ADivinagracia1/spectre-inverter-capstone/controls-pcb/Ext_CONN.PNG

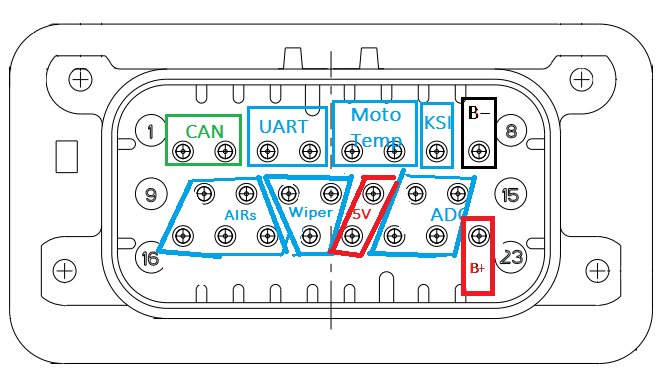
controls-pcb/Ext_CONN.PNG
