ADivinagracia1/spectre-inverter-capstone/controls-pcb/Ext_CONN_v2.PNG

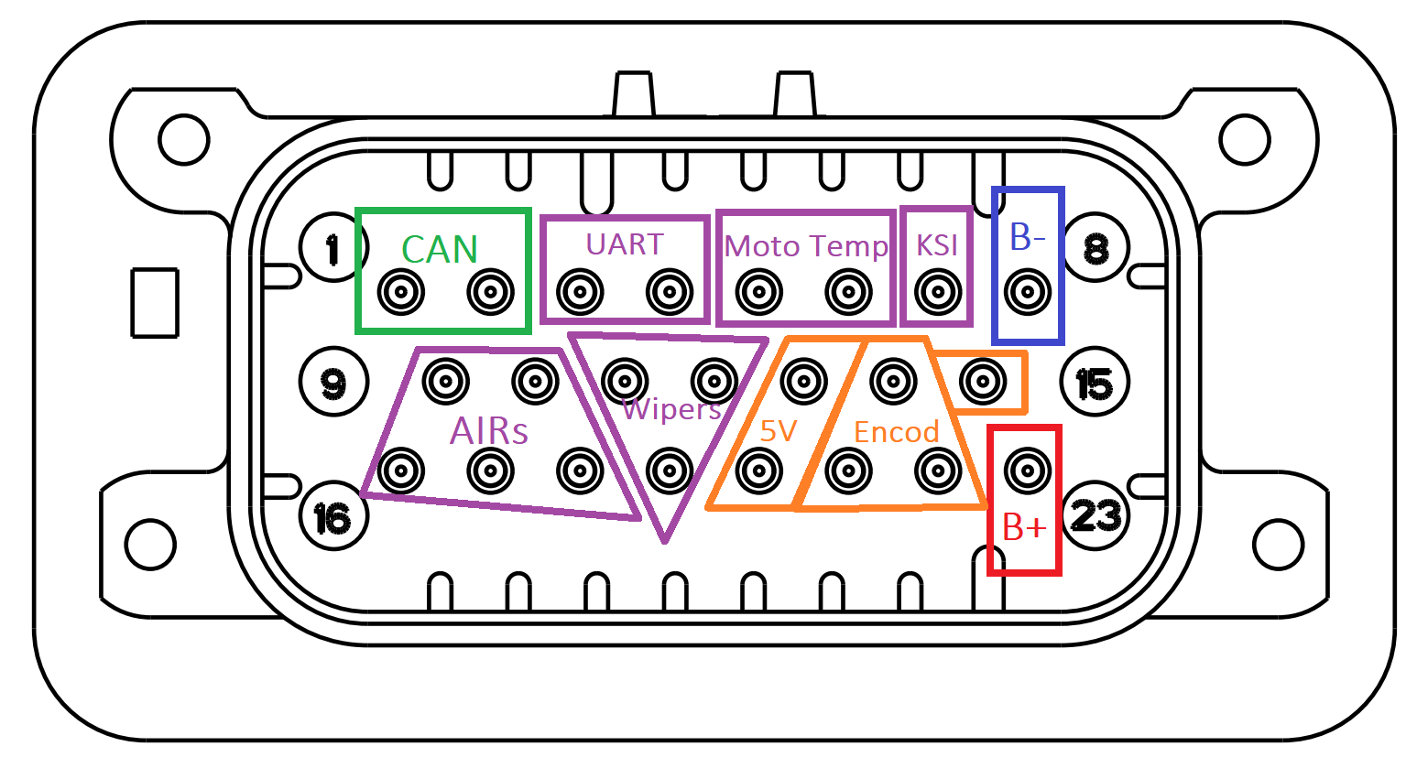
controls-pcb/Ext_CONN_v2.PNG
