ADivinagracia1/spectre-inverter-capstone/controls-pcb/Project Outputs for ControlBoard/ControlBoard.xlsx

Quantity | Designator | Description | Manufacturer | Manufacturer Part Number
6 | C1, C2, C3, C38, C44, C46 | CAP CER 0.1UF 50V Y5V 0805 | KEMET | C0805C104Z5VACTU
2 | C4, C5 | CAP CER 15PF 50V C0G/NPO 0603 | Yageo | CC0603JRNPO9BN150
17 | C6, C7, C8, C9, C10, C11, C12, C13, C14, C15, C21, C24, C32, C36, C49, C52, C53 | CAP CER 0.1UF 50V X7R 0603 | Kyocera AVX, Samsung | 06035C104JAT4A, CL10B104KB8NNNL
4 | C16, C17, C18, C19 | CAP CER 10UF 35V X5R 0603 | Murata | GRM188R6YA106MA73D
1 | C20 | CAP CER 22UF 10V X5R 0603 | Murata | GRM187R61A226ME15D
4 | C22, C23, C33, C34 | CAP CER 2.2UF 50V X5R 0805 | Samsung | CL21A225KBFNNNE
8 | C25, C26, C27, C29, C37, C54, C55, C56 | CAP CER 47UF 10V X5R 1206 | Samsung | CL31A476MPHNNNE
2 | C28, C35 | CAP CER 330PF 100V X7R 0805 | Wurth Electronics | 885012207113
2 | C30, C57 | CAP CER 4700PF 100V X7R 0603 | TDK | CGA3E2X7R2A472K080AA
1 | C31 | CAP CER 10UF 100V X7S 2220 | TDK | C5750X7S2A106K230KB
2 | C39, C40 | CAP CER 1UF 50V X5R 0805 | KEMET | C0805C105K5PACTU
1 | C41 | CAP CER 10UF 25V X7R 1206 | Samsung | CL31B106KAHZW6E
1 | C42 | CAP CER 10000PF 50V X7R 0603 | Kyocera AVX | 06035C103KAT4A
1 | C43 | CAP CER 10UF 16V X5R 0805 | Samsung | CL21A106KOQNNNE
1 | C45 | CAP CER 4.7UF 50V X7R 1206 | TDK | C3216X7R1H475K160AC
2 | C47, C51 | CAP CER 22UF 16V X5R 0805 | Samsung | CL21A226KOQNNNE
1 | C48 | CAP CER SMD 0805 .01UF X7R 5% 50V | KEMET | C0805C103J5RAC7210
1 | C50 | CAP CER 0.047UF 50V X7R 0805 | Yageo | CC0805KRX7R9BB473
8 | D1, D3, D5, D6, D7, D8, D11, D12 | LED GREEN CLEAR 0603 SMD | Wurth Electronics | 150060VS75000
2 | D2, D9 | DIODE SCHOTTKY 60V 5A SMC | Diodes | B560C-13-F
1 | D4 | LED YELLOW CLEAR 0603 SMD | Wurth Electronics | 150060YS75000
1 | D10 | LED RED CLEAR 0603 SMD | Wurth Electronics | 150060RS75000
1 | FB1 | FERRITE BEAD 60 OHM 0805 1LN | Taiyo Yuden | BKP2125HS600-T
1 | FB2 | FERRITE BEAD 220 OHM 0805 1LN | Murata | BLM21PG221SN1D
2 | FB3, FB4 | FERRITE BEAD 23 OHM 1806 1LN | Taiyo Yuden | FBMJ4516HL230NTV
1 | J1 | CONN HEADER VERT 72POS 2.54MM | 3M | 929710-06-36-RK
1 | J2 | CONN HEADER VERT 23POS 4MM | TE Connectivity AMP | 776200-1
1 | J3 | CONN HEADER VERT 16POS 2.54MM | Sullins | PRPC008DAAN-RC
1 | J4 | CONN HEADER VERT 2POS | 3M | 929710-06-01-RK
1 | J5 | CONN HEADER VERT 8POS 2.54MM | Sullins | PREC004DAAN-RC
3 | J6, J7, JP2 | CONN HEADER VERT 2POS 2.54MM | Harwin | M20-9990246
3 | K1, K2, K3 | General Purpose Relay SPST-NO (1 Form A) 12VDC Coil Through Hole | TE Connectivity | OJE-SH-112DM,000
2 | L1, L2 | FIXED IND 3.3UH 5.5A 40.4MOHM SM | Vishay Dale | IHLP2020CZER3R3M11
1 | L3 | FIXED IND 22UH 630MA 700MOHM SMD | Recom | RLS-226
2 | Q1, Q2 | MOSFET N CH 60V 20A TO252 | Diodes | DMN6040SK3-13
9 | R1, R5, R6, R8, R13, R28, R38, R42, R53 | RES SMD 2.2K OHM 5% 1/10W 0603 | Yageo | AC0603JR-072K2L
3 | R2, R4, R41 | RES SMD 62K OHM 1% 1/4W 0603 | Panasonic | ERJ-PA3F6202V
1 | R3 | RES SMD 120 OHM 1% 1/10W 0603 | Yageo | RC0603FR-07120RL
7 | R7, R9, R10, R33, R44, R45, R48 | RES SMD 0 OHM JUMPER 1/10W 0603 | Yageo | RC0603JR-070RL
2 | R11, R14 | RES SMD 10K OHM 5% 1/10W 0603 | Yageo | RC0603JR-0710KL
1 | R12 | THERMISTOR NTC 10KOHM 3380K 0603 | Murata | NCP18XH103F03RB
7 | R15, R16, R19, R22, R23, R25, R27 | RES SMD 1K OHM 1% 1/10W 0603 | Vishay Dale | CRCW06031K00FKEA
1 | R17 | RES SMD 100K OHM 1% 1/10W 0603 | Yageo | RC0603FR-07100KL
2 | R18, R24 | RES SMD 49.9KOHM 0.5% 1/10W 0603 | Vishay Dale | CRCW060349K9DHEAP
1 | R20 | RES SMD 17.8K OHM 1% 1/10W 0603 | Yageo | RC0603FR-0717K8L
1 | R21 | RES SMD 102K OHM 1% 1/10W 0603 | Samsung | RC1608F1023CS
1 | R26 | RES SMD 30K OHM 1% 1/10W 0603 | Yageo | RC0603FR-0730KL
2 | R29, R50 | RES SMD 22.1K OHM 1% 1/10W 0603 | Vishay | CRCW060322K1FKEA
1 | R30 | RES SMD 3K OHM 5% 1/10W 0603 | Yageo | RC0603JR-073KL
3 | R31, R46, R54 | RES SMD 5.1K OHM 1% 1/10W 0603 | TE Connectivity | 1623257-1
1 | R32 | RES 499K OHM 1% 1/10W 0603 | Vishay | CRCW0603499KFKEAC
2 | R34, R35 | RES SMD 270 OHM 0.5% 1/10W 0603 | Yageo | RT0603DRE07270RL
2 | R36, R37 | RES SMD 27 OHM 5% 1/10W 0603 | Panasonic | ERJ-3GEYJ270V
1 | R39 | RES SMD 25 MOHM 1% 2W 2512 | Riedon | CSR2512A0R025F
1 | R40 | RES SMD 10 OHM 1% 1/10W 0603 | Yageo | RC0603FR-0710RL
1 | R43 | RES SMD 200K OHM 1% 1/10W 0603 | Yageo | AF0603FR-07200KL
1 | R47 | RES SMD 7.5K OHM 5% 1/10W 0603 | Yageo | RC0603JR-077K5L
1 | R49 | RES SMD 20K OHM 5% 1/10W 0603 | Yageo | RC0603JR-0720KL
1 | S1 | SWITCH TACTILE SPST-NO 0.05A 12V | ITT C&K | PTS645SM43SMTR92LFS
2 | TVS1, TVS2 | TVS DIODE 5.5V 6SON | Texas Instruments | TPD4E001DRSR
1 | TVS3 | TVS DIODE 18VWM 39.3VC SMA | STMicroelectronics | SMAJ18CA-TR
1 | U1 | IC TRANSCEIVER 1/1 8SOIC | Texas Instruments | TCAN332DR
1 | U2 | IC WDT CIRCUIT SOT323-5 | STMicroelectronics | STWD100PYW83F
1 | U3 | IC MCU 32BIT 256KB FLASH 64LQFP | Texas Instruments | F280049CPMS
2 | U4, U7 | IC REG BUCK ADJUSTABLE 5A 8SOPWR | Texas Instruments | LMR14050SSQDDARQ1
2 | U5, U6 | IC OR CTRLR SRC SELECT 8TSSOP | Texas Instruments | TPS2115APWR
1 | U8 | Module DC-DC 5VIN 1-OUT 5V 0.2A 1W 4-Pin SIP Tube | Recom | ROE-0505S
1 | U10 | IC COMPAR PWR RRI DL PP 8VSSOP | Texas Instruments | TLV3202AIDGK
1 | U11 | IC REG LINEAR 5V 200MA SMV | Toshiba | TAR5S50TE85LF
1 | U12 | IC REG LINEAR 3.3V 1A SOT223 | Diodes | AZ1117IH-3.3TRG1
1 | U13 | IC USB SERIAL FULL UART 20SSOP | FTDI | FT231XS-R
1 | U14 | IC SURGE STOPPER HV 12-MSOP | Analog Devices / Linear Technology | LT4363CMS-2#PBF
1 | X1 | CONN_JTAG_10pin .050 Connector Dual Header 10 Position Surface Mount | Samtec | FTSH-105-01-F-DV-K
1 | X2 | CONN_USB - micro B USB 2.0 Receptacle Connector 5 Position Surface Mount, Right Angle, Horizontal | Amphenol FCI | 10118192-0001LF
1 | Y1 | CRYSTAL 20.0000MHZ 18PF SMD | ECS International | ECS-200-18-30B-AGN-TR
3 | Z1, Z2, Z3 | DIODE ZENER 5.1V 500MW SOD123 | ON Semiconductor | SZMMSZ4689T1G
1 | Z4 | Diode Zener Single 15V 5% 500mW 2-Pin SMA T/R | ON Semiconductor | 1SMA5929BT3G
