ADivinagracia1/spectre-inverter-capstone/power-pcb/Project Outputs for PowerBoard/PowerBoard.xlsx

Comment | Description | Designator | Manufacturer Part Number | Quantity
1uF | CAP CER 1UF 50V X5R 0805 | C1, C2, C4, C6, C9, C10, C12, C14, C17, C18, C20, C22, C25, C26, C28, C30, C33, C34, C36, C38, C42, C43, C45, C47, C59 | C0805C105K5PACTU | 25
4.7uF | CAP CER 4.7UF 50V X7R 1206 | C3, C11, C19, C27, C35, C44 | C3216X7R1H475K160AC | 6
0.1uF | CAP CER 0.1UF 50V Y5V 0805 | C5, C13, C21, C29, C37, C46, C50, C51, C52, C53, C54, C55, C56, C57 | C0805C104Z5VACTU | 14
15uF | CAP CER 15UF 25V X7R 1812 | C7, C8, C15, C16, C23, C24, C31, C32, C40, C41, C48, C49 | C4532X7R1E156M280KB | 12
150uF | CAP POLYMER HYBRID 150UF 50V SMD | C39, C66, C67 | EEHZS1H151P | 3
50UF | CAP FILM 50UF 10% 500VDC RADIAL | C60, C61, C62, C63, C64, C65 | C4AQLBW5500A3JK | 6
37pF | CAP CER 39PF 50V C0G/NP0 0805 | C68, C69, C70 | CL21C390JBANNNC | 3
US1NWF-7 | DIODE GEN PURP 1.2KV 1A SOD123F | D1, D2, D3 | US1NWF-7 | 3
M8 Terminal | M8 Screw terminal for HV connections | J1, J3, J4, J5, J6 |  | 5
1-534998-5 | 30 Position Receptacle Connector 0.100" (2.54mm) Through Hole Gold | J2 | 1-534998-5 | 1
PPPC021LFBN-RC | CONN HDR 2POS 0.1 GOLD PCB | J7 | PPPC021LFBN-RC | 1
STGB30V60DF | IGBT 600V 60A 258W D2PAK | Q1_HA, Q1_LA, Q2_HA, Q2_LA, Q3_HA, Q3_LA, Q4_HA, Q4_LA, Q5_HA, Q5_LA, Q6_HA, Q6_LA, Q7_HA, Q7_LA, Q8_HB, Q8_LB, Q9_HB, Q9_LB, Q10_HB, Q10_LB, Q11_HB, Q11_LB, Q12_HB, Q12_LB, Q13_HB, Q13_LB, Q14_HB, Q14_LB, Q15_HC, Q15_LC, Q16_HC, Q16_LC, Q17_HC, Q17_LC, Q18_HC, Q18_LC, Q19_HC, Q19_LC, Q20_HC, Q20_LC, Q21_HC, Q21_LC | STGB30V60DF | 42
STL12N60M2 | MOSFET N-CH 600V 6.5A POWERFLAT | Q22 | STL12N60M2 | 1
10R | RES SMD 10 OHM 1% 1/10W 0603 | R1, R7_HA, R7_LA, R8_HA, R8_LA, R9_HA, R9_LA, R10_HA, R10_LA, R11_HA, R11_LA, R12_HA, R12_LA, R13_HA, R13_LA, R14, R20_HB, R20_LB, R21_HB, R21_LB, R22_HB, R22_LB, R23_HB, R23_LB, R24_HB, R24_LB, R25_HB, R25_LB, R26_HB, R26_LB, R27, R33_HC, R33_LC, R34_HC, R34_LC, R35_HC, R35_LC, R36_HC, R36_LC, R37_HC, R37_LC, R38_HC, R38_LC, R39_HC, R39_LC, R102, R103, R104, R105, R106, R107 | RC0603FR-0710RL | 51
120R | RES SMD 120 OHM 1% 1/10W 0603 | R2, R3, R5, R6, R15, R16, R18, R19, R28, R29, R31, R32 | RC0603FR-07120RL | 12
200uR | RES SMD 200 UOHM 1% 12W 3920 | R4, R17, R30 | CSS2H-3920R-L200FE | 3
10K | RES SMD 10K OHM 5% 1/10W 0603 | R40, R41, R42, R60 | RC0603JR-0710KL | 4
10K NTC | THERMISTOR NTC 10KOHM 3380K 0603 | R45, R46, R47 | NCP18XH103F03RB | 3
200K | RES SMD 200K OHM 1% 1/10W 0603 | R50 | AF0603FR-07200KL | 1
2K | RES SMD 2K OHM 1% 1/4W 0603 | R51 | CRCW06032K00FKEAHP | 1
10K | RES SMD 10K OHM 1% 3/4W 1206 | R52, R53, R54, R55, R56, R57, R58, R59, R61, R62, R63, R64, R65, R66, R67, R68, R70, R71, R72, R73, R74, R75, R76, R77, R78, R79, R80, R81, R82, R83, R84, R85, R86, R87, R88, R89, R90, R91, R92, R93, R94, R95, R96, R97, R98, R99, R100, R101 | RCA120610K0FKEAHP | 48
MGJ2D121509SC | Isolated Module DC DC Converter Output 15V -8.7V - 80mA, 40mA 10.8V - 13.2V Input | U1, U3, U5, U7, U9, U11 | MGJ2D121509SC | 6
STGAP2HSMTR | GALVANICALLY ISOLATED 4 A SINGLE GATE DRIVER | U2, U4, U6, U8, U10, U12 | ERF8-010-07.0-L-DV-L-K-TR | 6
AMC1200BDUBR | IC OPAMP ISOLATION 1 CIRC 8SOP | U13, U14, U15, U16 | AMC1200BDUBR | 4
BU4SU69G2 | IC INVERTER 1CH 1-INP 5SSOP | U18 | BU4SU69G2-TR | 1
