ADivinagracia1/spectre-inverter-capstone/controls-pcb/ControlBoard.pdf

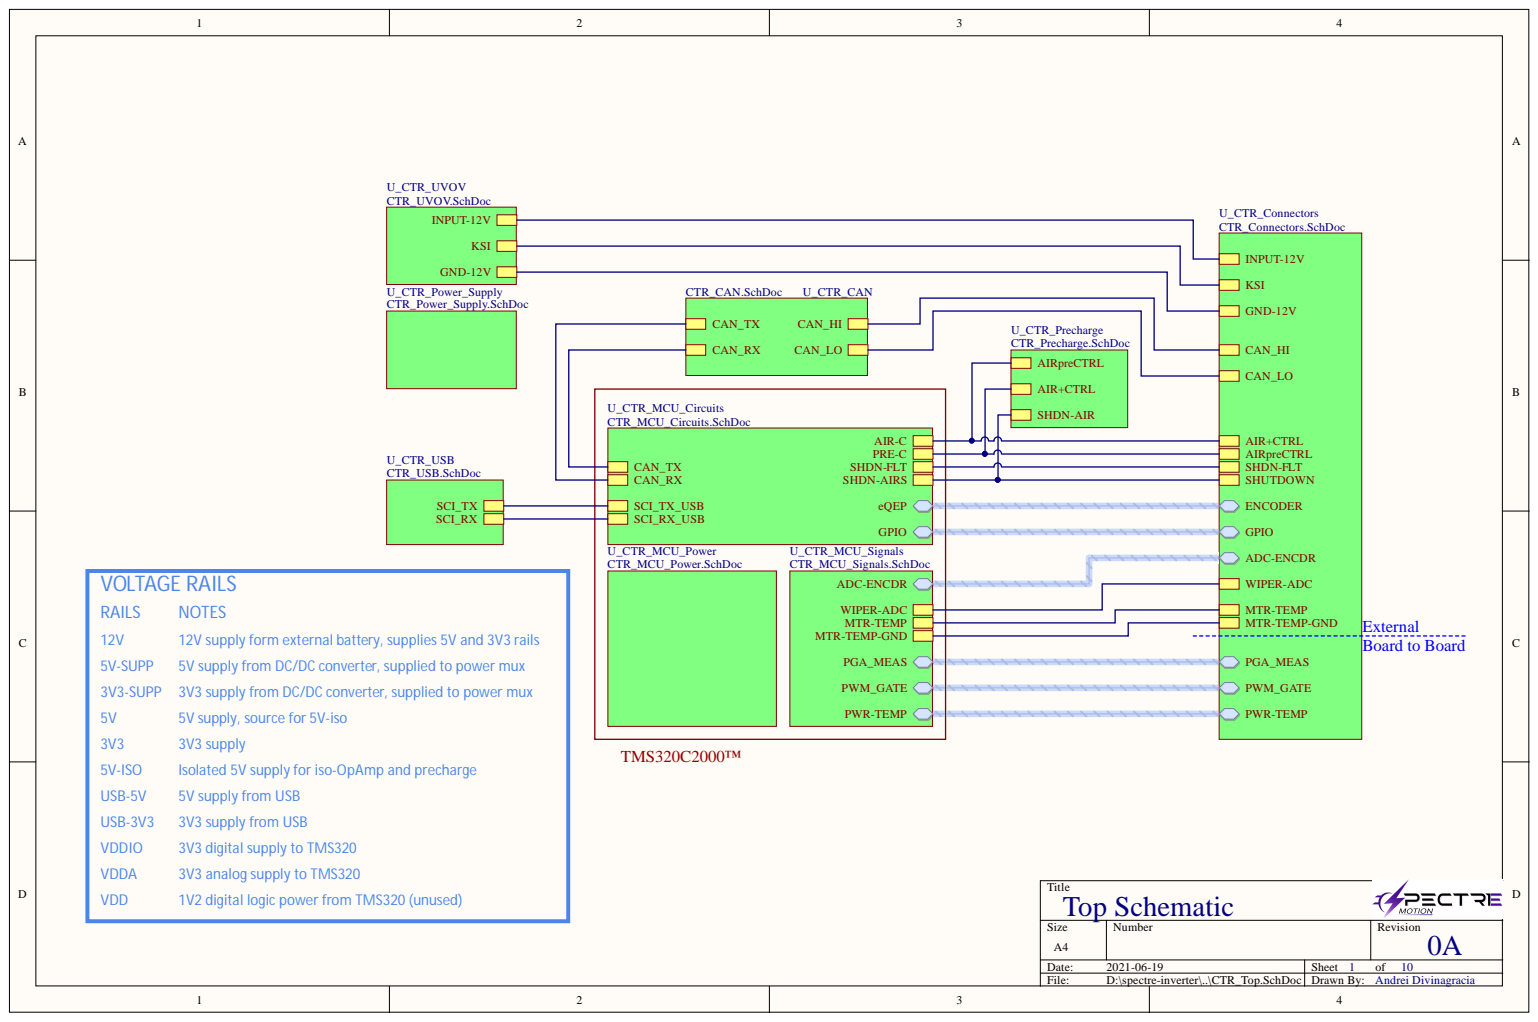
[picture p3: page 1]

12V supply form external battery, supplies 5V and 3V3 rails
5V supply from DC/DC converter, supplied to power mux
3V3 supply from DC/DC converter, supplied to power mux
5V supply, source for 5V-iso
3V3 supply
Isolated 5V supply for iso-OpAmp and precharge
5V supply from USB
3V3 supply from USB
3V3 digital supply to TMS320
3V3 analog supply to TMS320
1V2 digital logic power from TMS320 (unused)

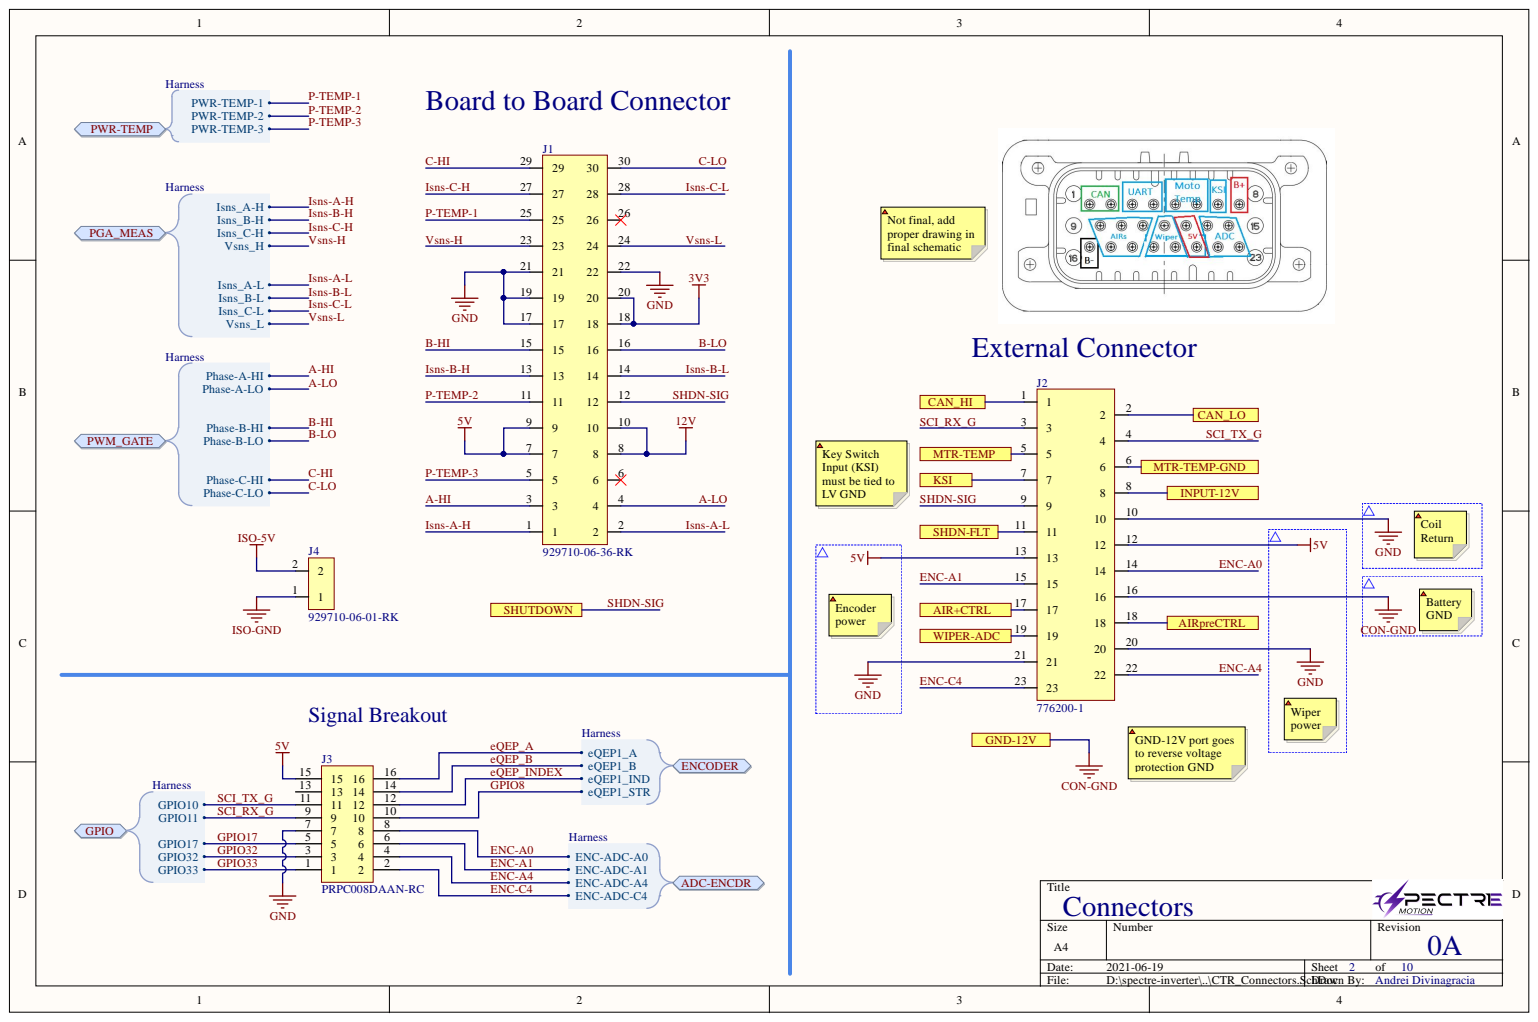
[picture p4: page 2]

Board to Board Connector

Key Switch
Input (KSI)
must be tied to
LV GND

GND

CON-GND

ENC-A0
ENC-A1
ENC-A4

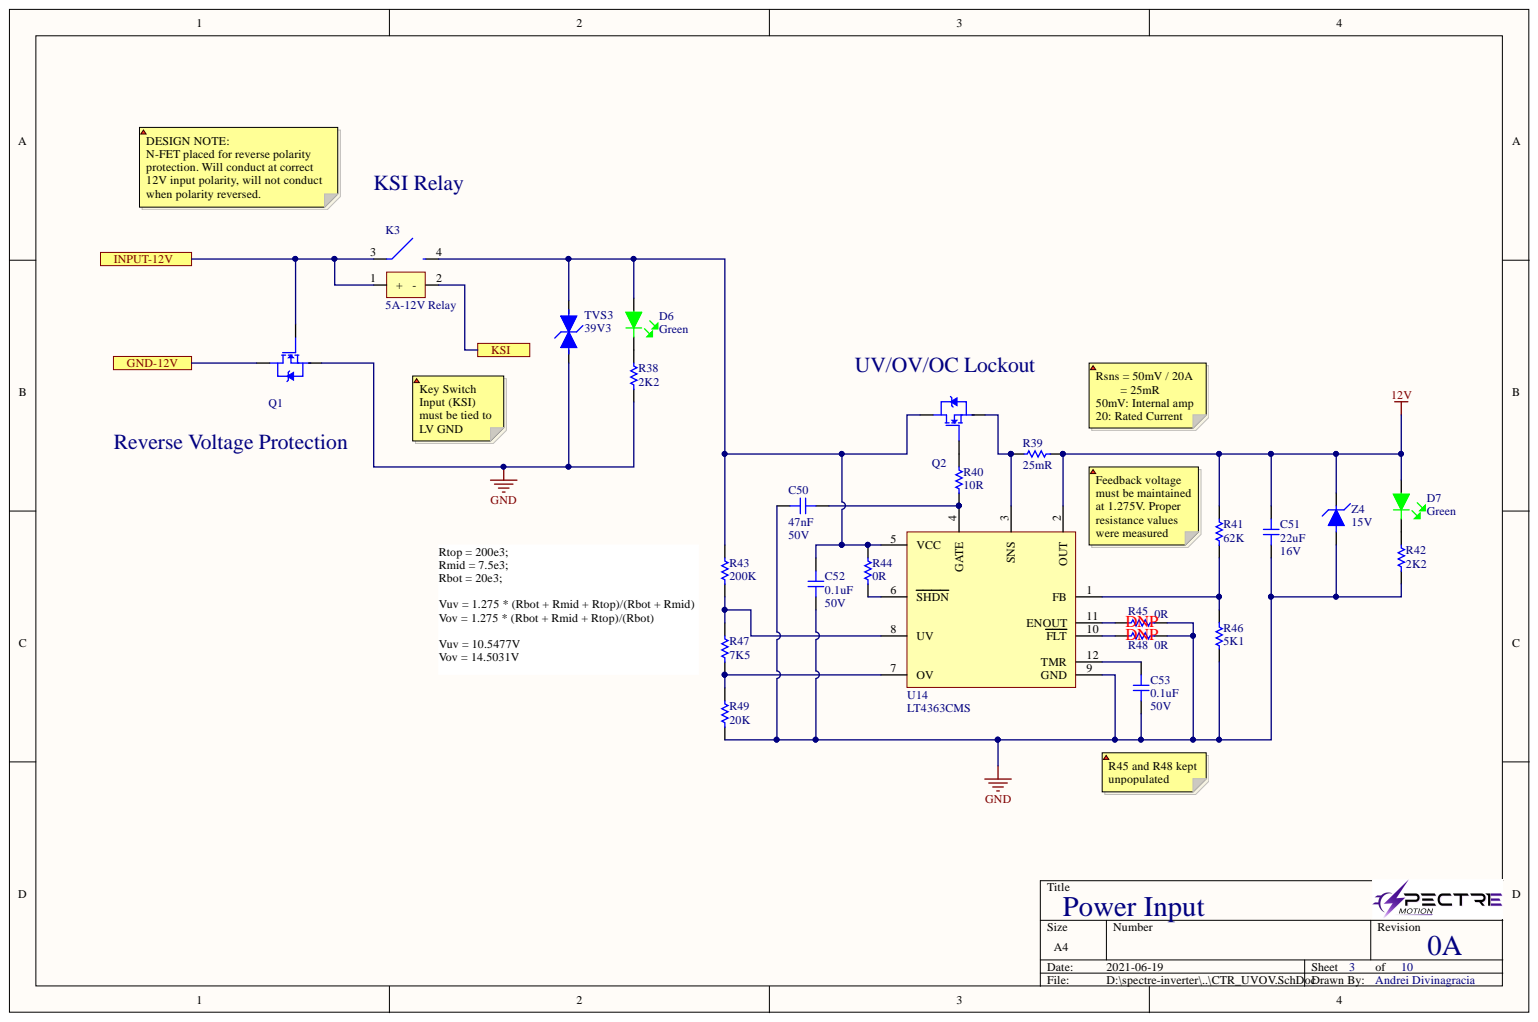
[picture p5: page 3]

UV/OV/OC Lock

Power Input DNP DNP

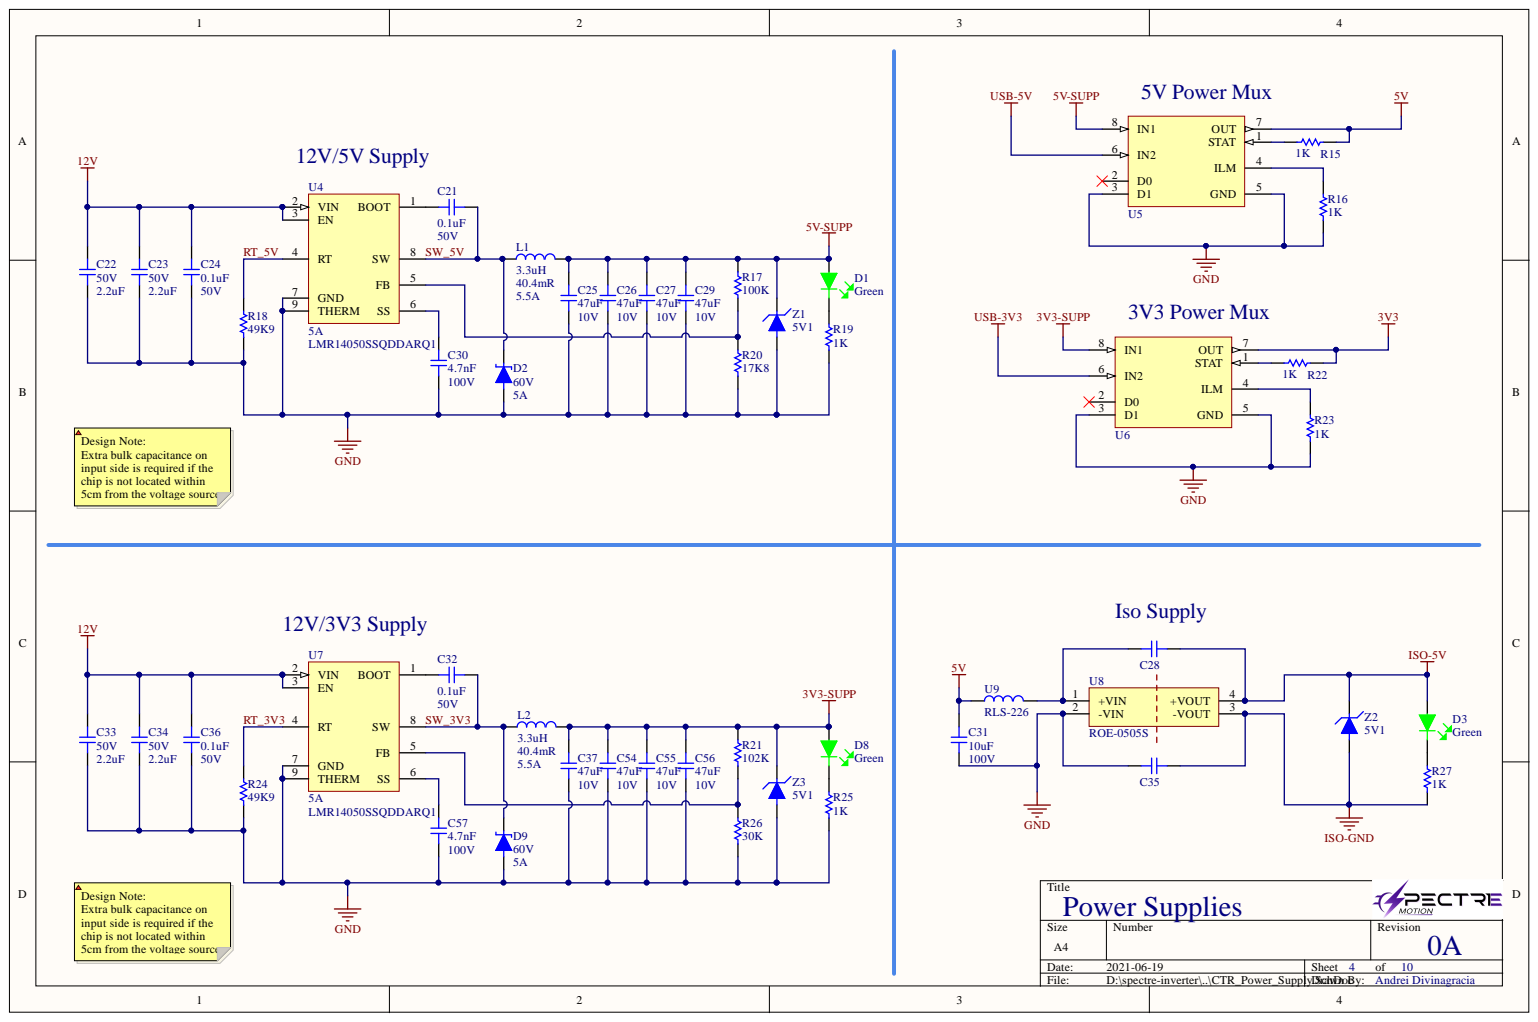
[picture p6: page 4]

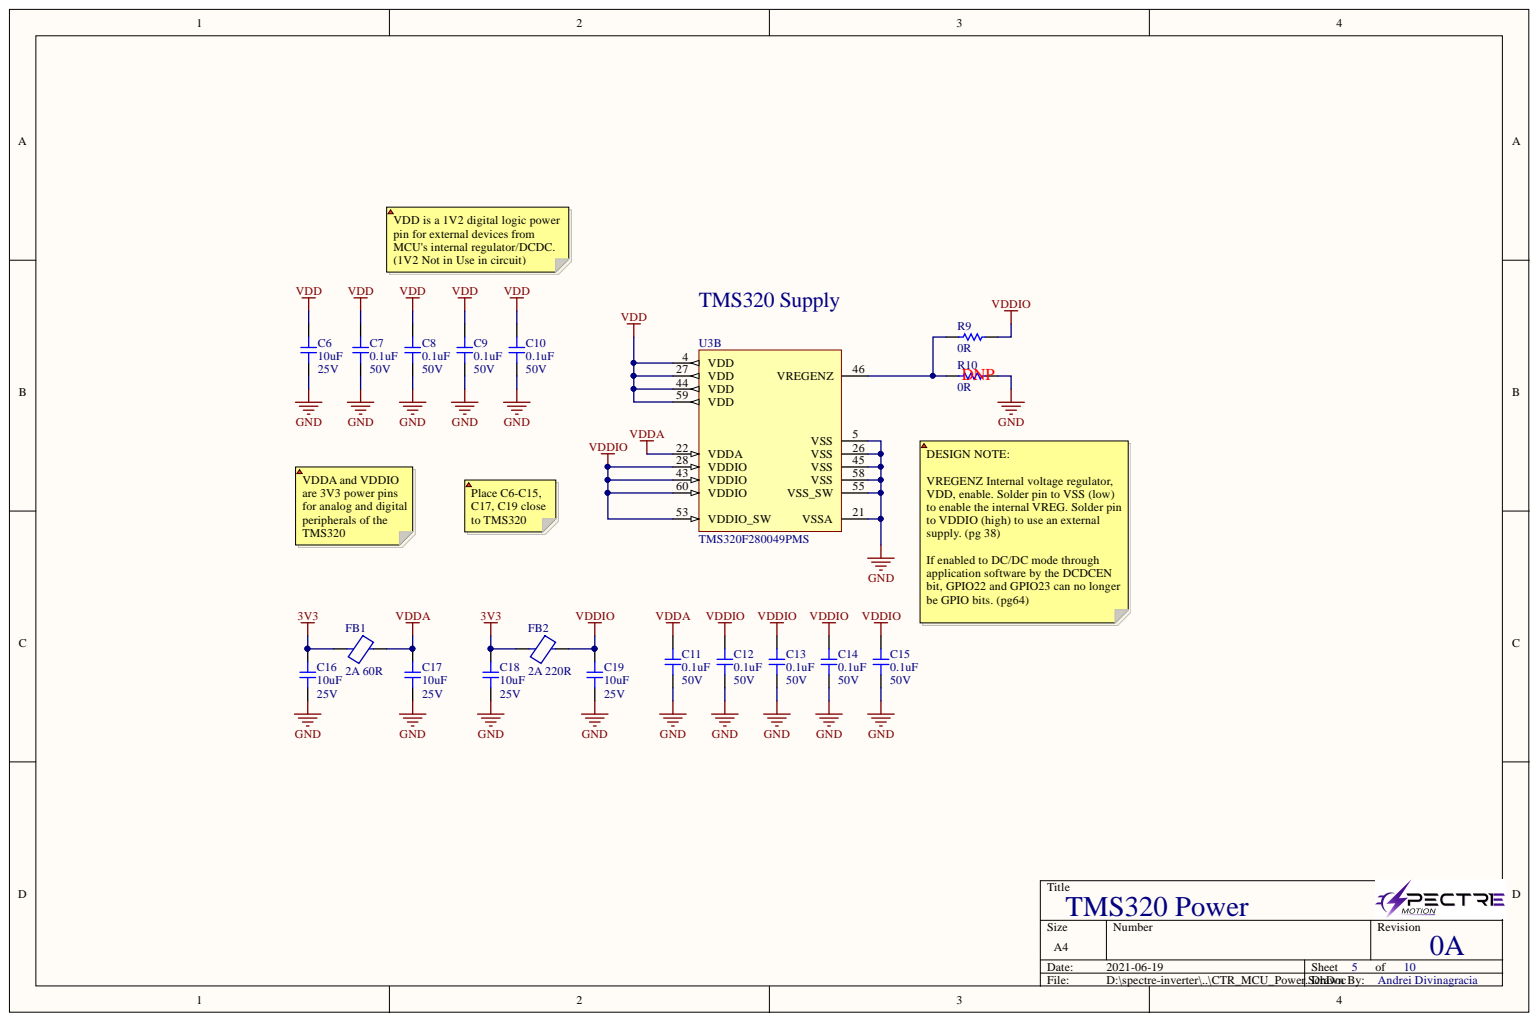
[picture p7: page 5]

VDD is a 1V2 digital logic power
pin for external devices from
MCU's internal regulator/DCDC.
(1V2 Not in Use in circuit)

VDDA and VDDIO
are 3V3 power pins
for analog and digital
peripherals of the
TMS320

VREGENZ Internal voltage regulator,
VDD, enable. Solder pin to VSS (low)
to enable the internal VREG. Solder pin
to VDDIO (high) to use an external
supply. (pg 38)

If enabled to DC/DC mode through
application software by the DCDCEN
bit, GPIO22 and GPIO23 can no longer
be GPIO bits. (pg64)

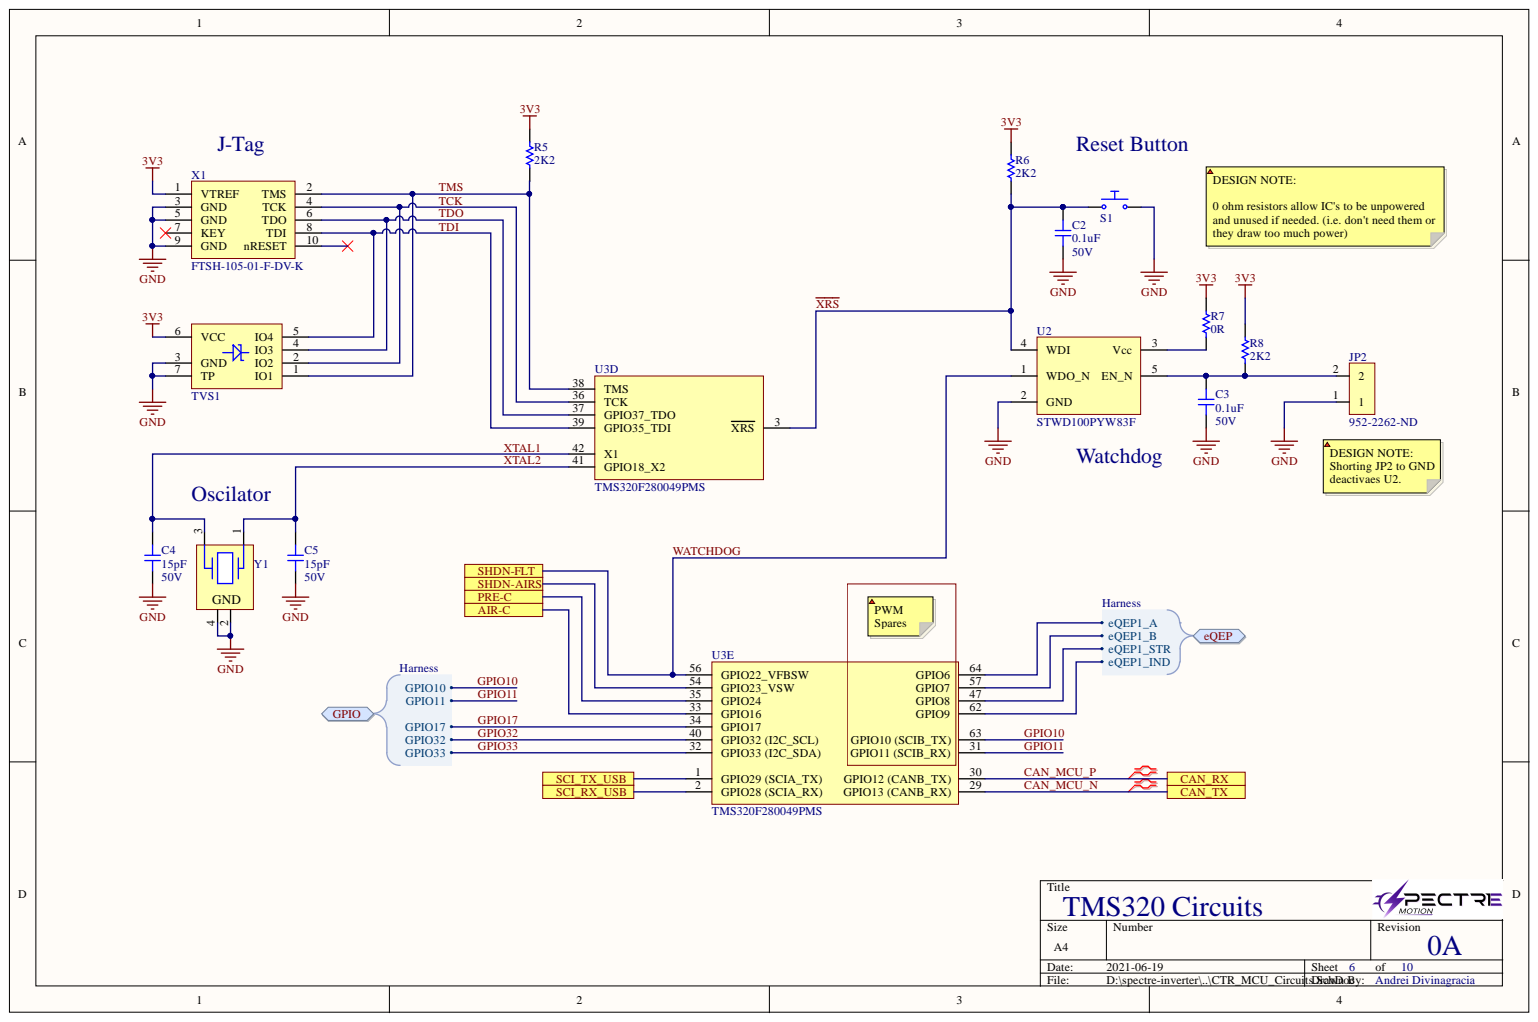
[picture p8: page 6]

0 ohm resistors allow IC's to be unpowered
and unused if needed. (i.e. don't need them or
they draw too much power)

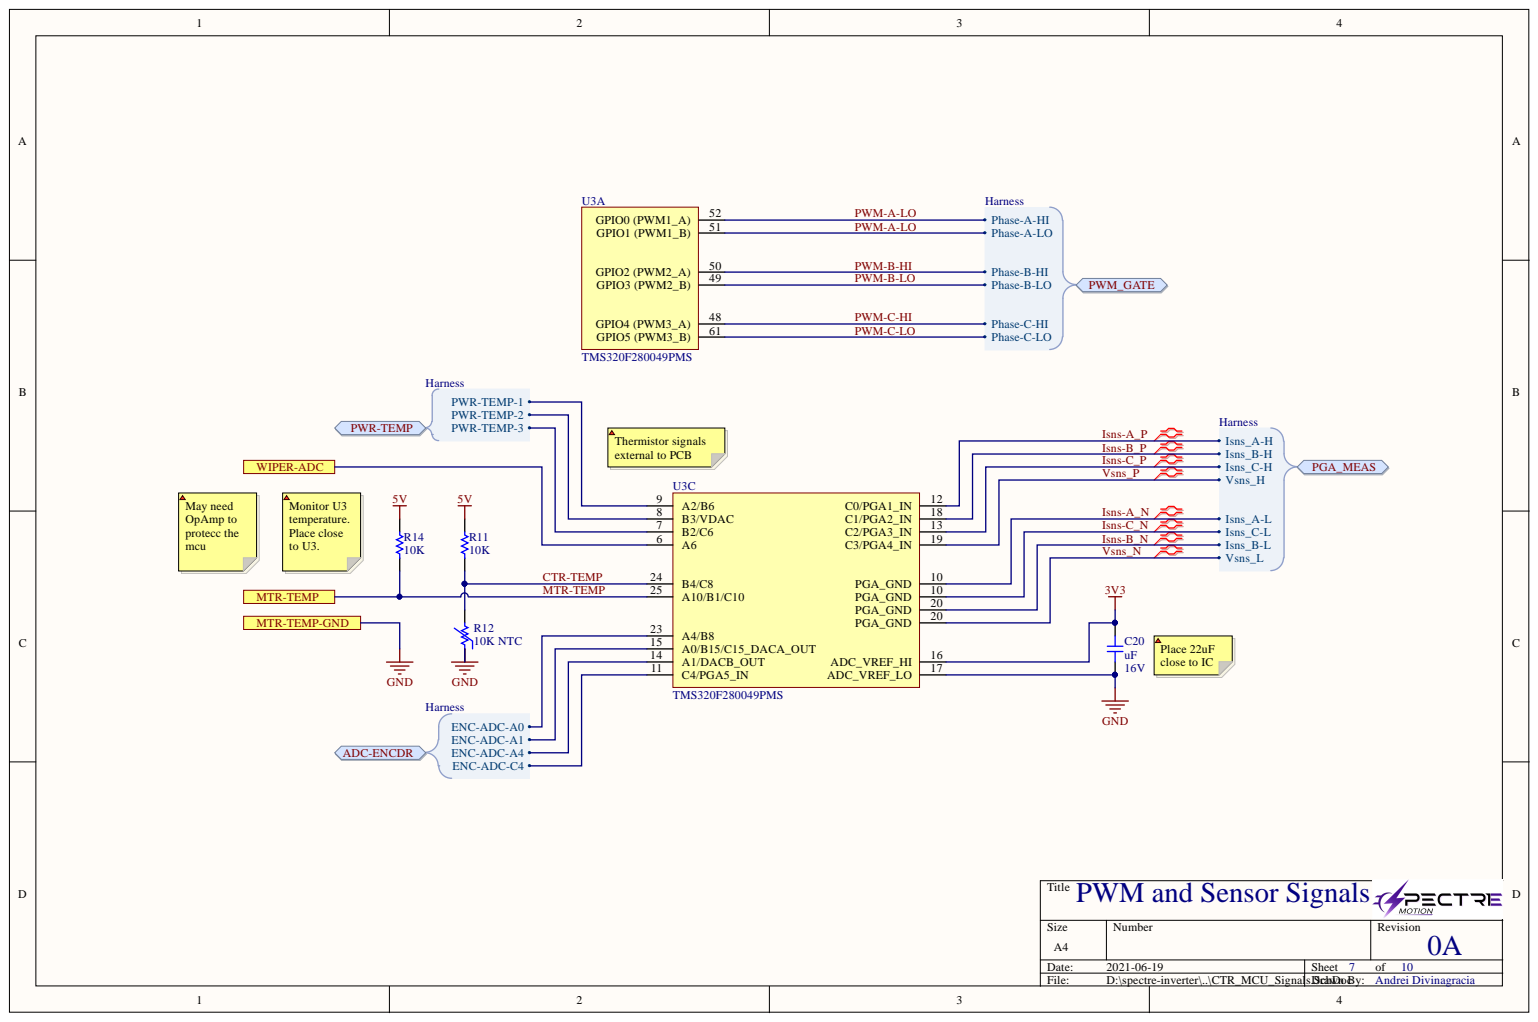
[picture p9: page 7]

PWM and Sensor Signals
Title

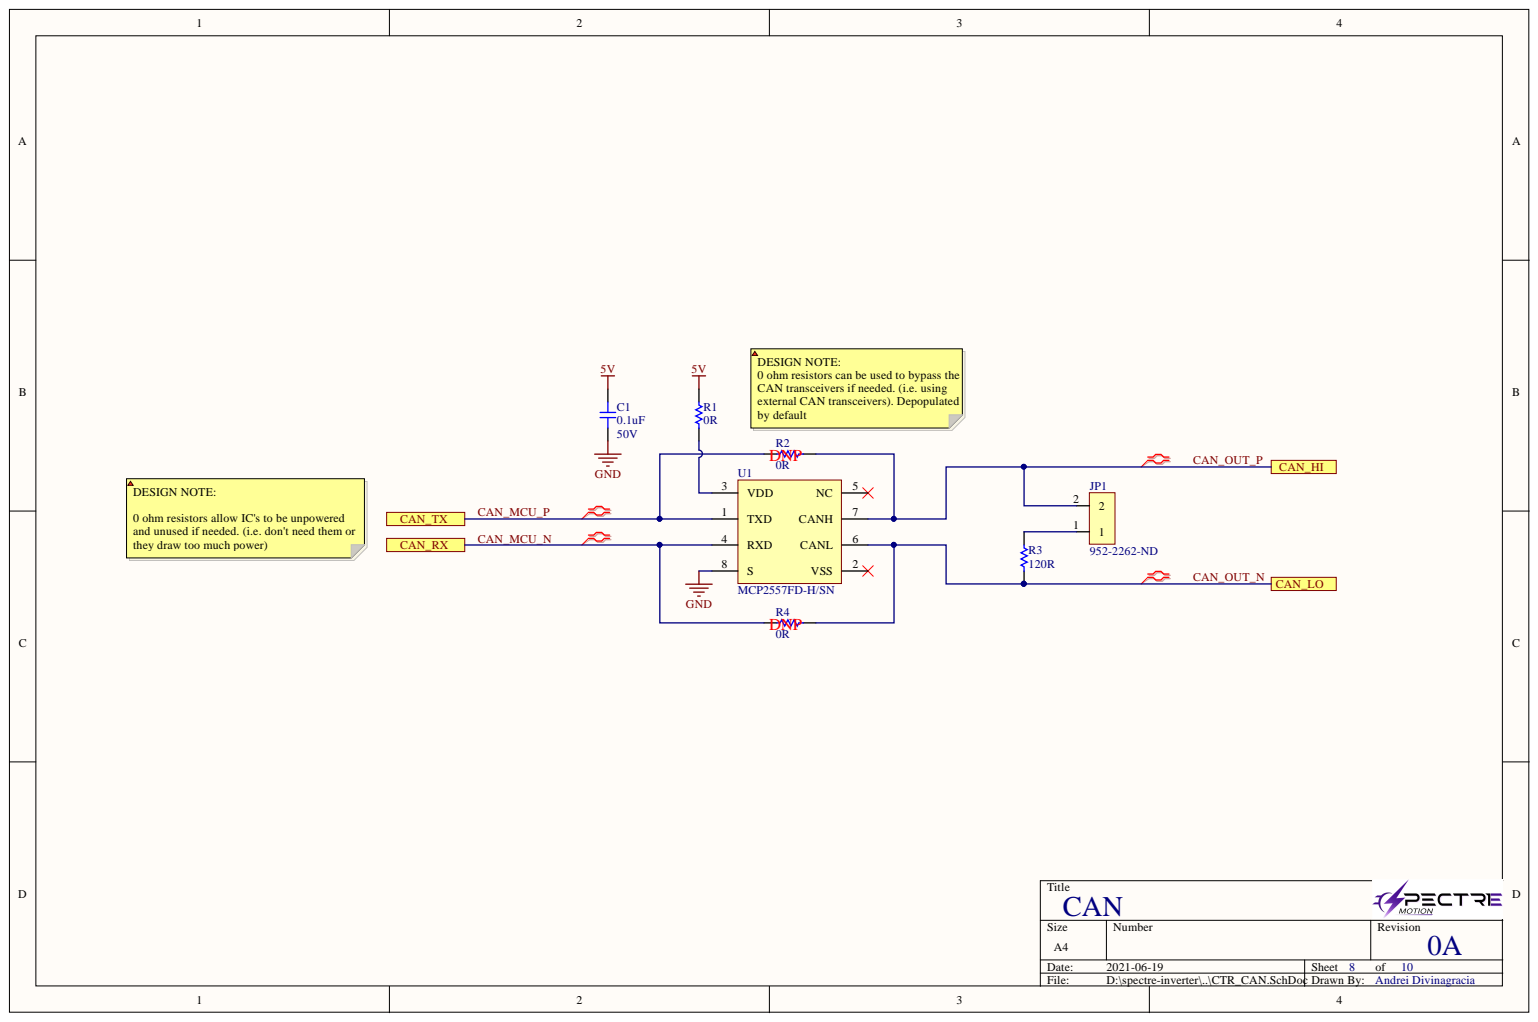
[picture p10: page 8]

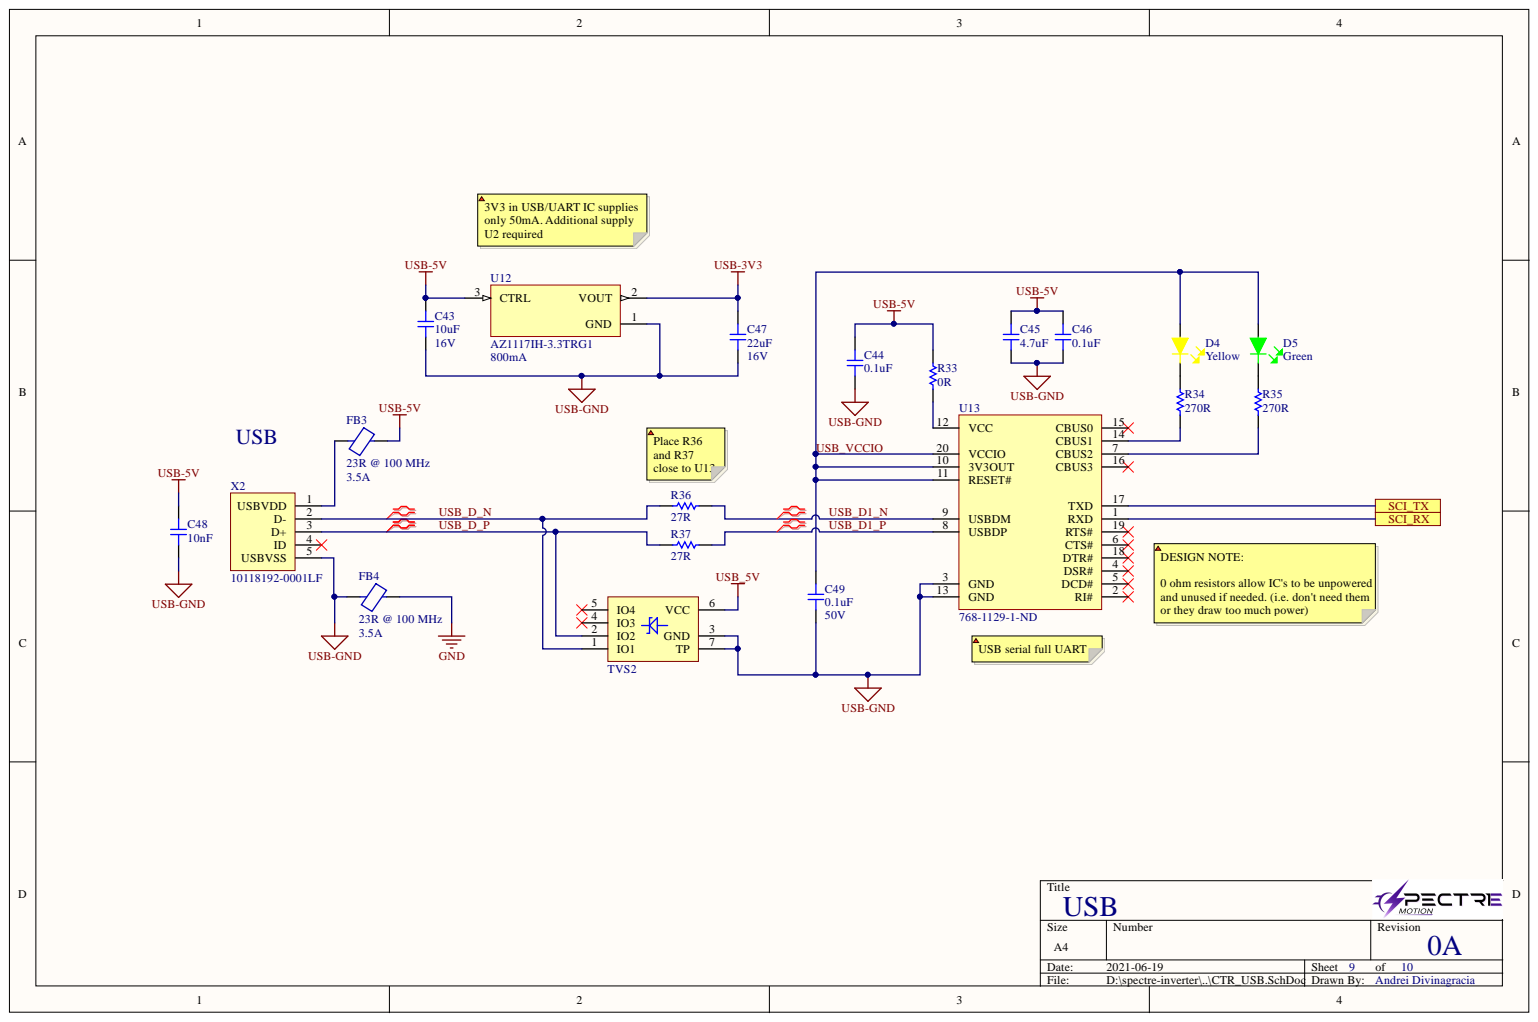
[picture p11: page 9]

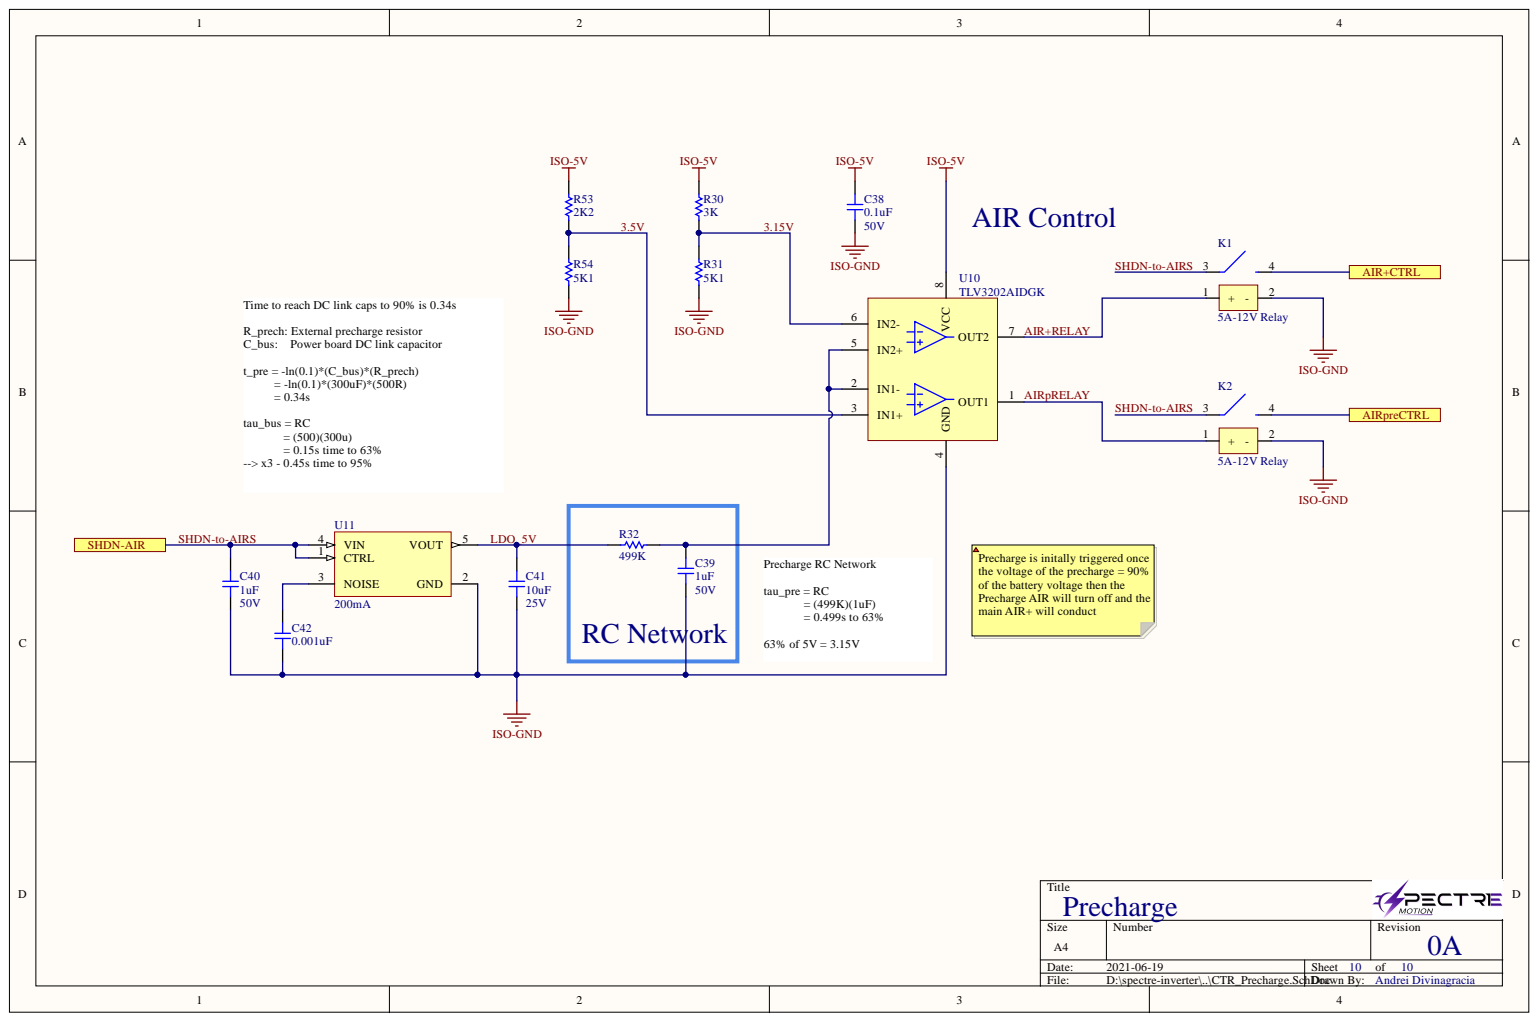
[picture p12: page 10]
