ADivinagracia1/spectre-inverter-capstone/power-pcb/PowerBoard.pdf

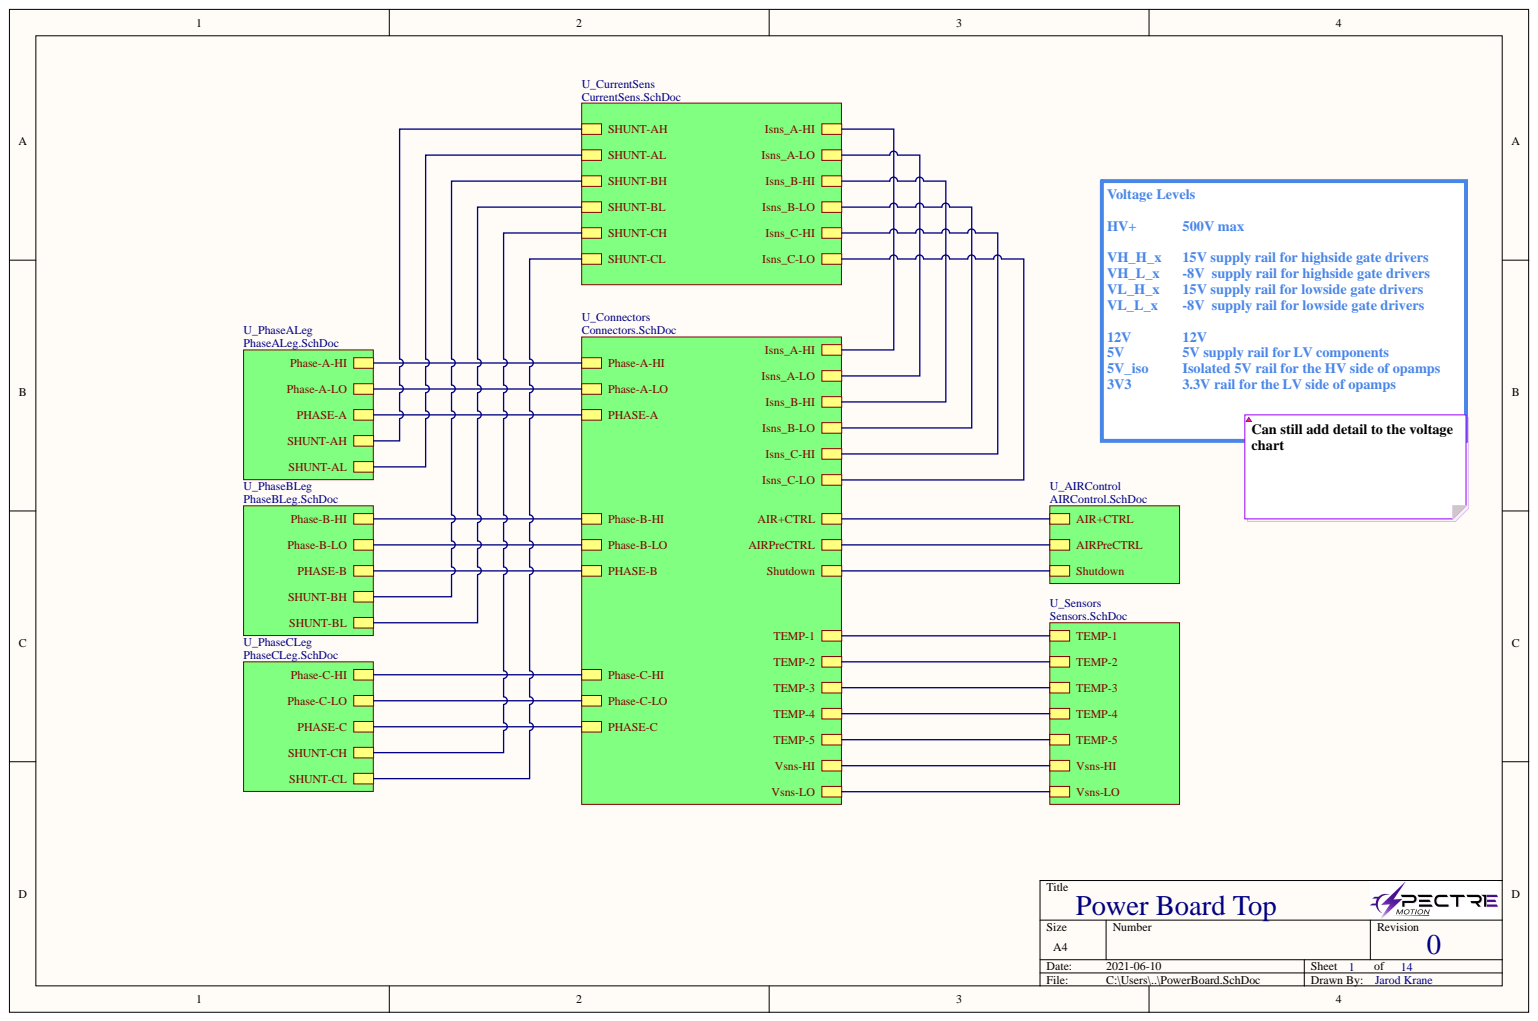
[picture p13: page 1]

Can still add detail to the voltage
chart

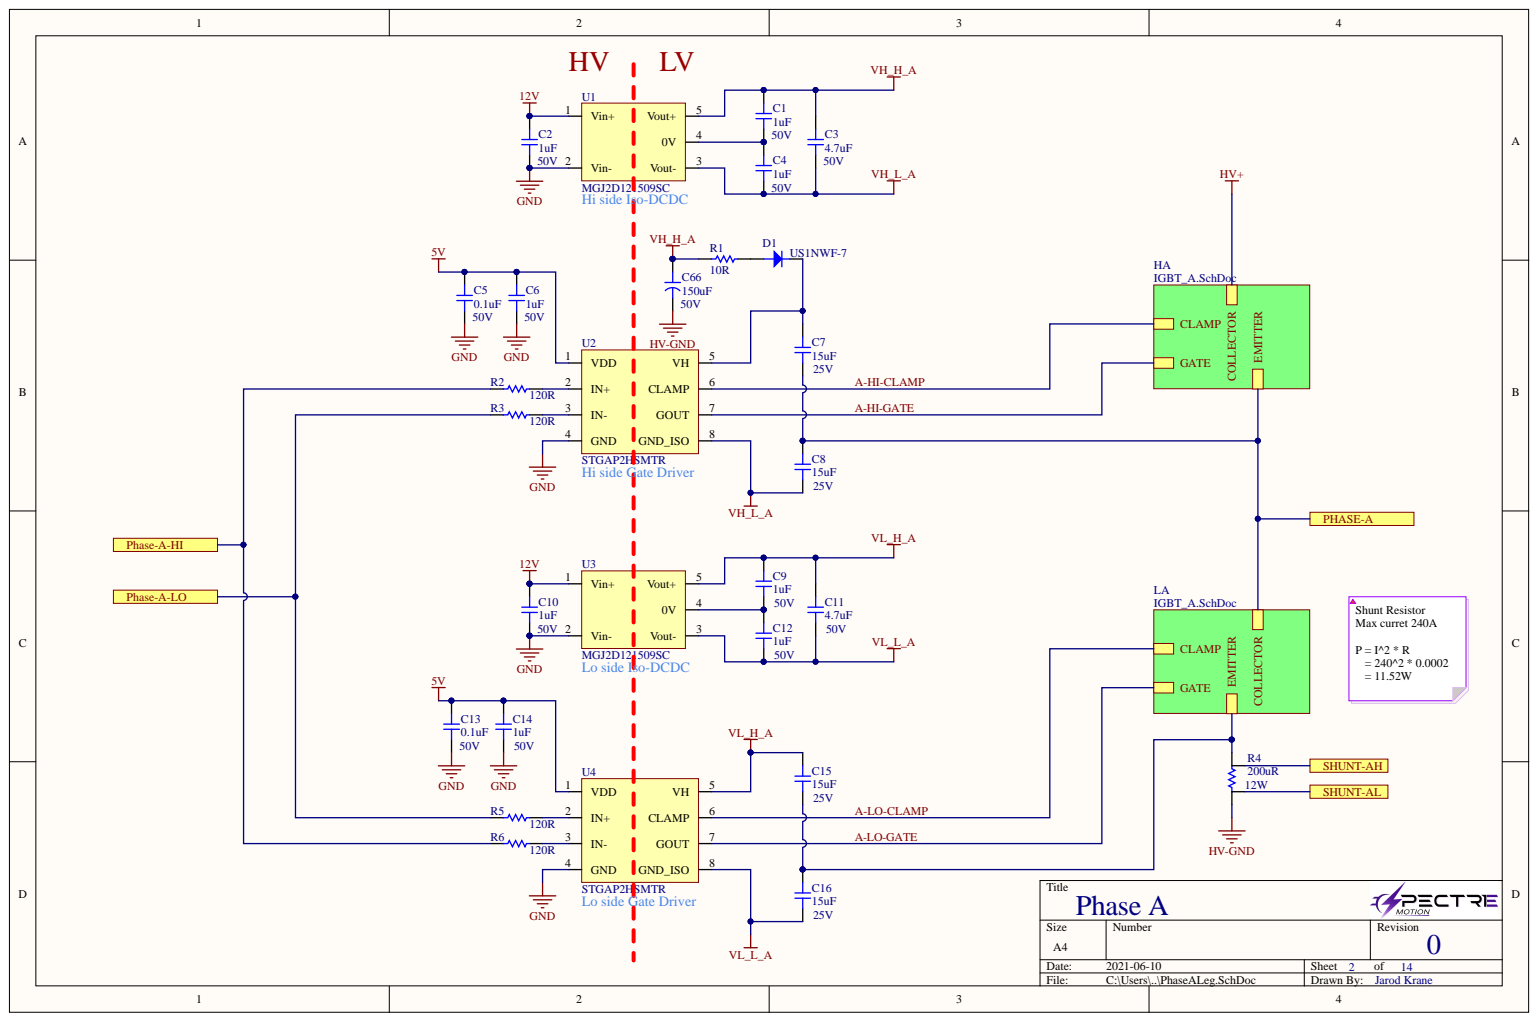
[picture p14: page 2]

6 | 25V A-HI-CLAMP

120R R3 3 | | 7 | A-HI-GATE

C15 15uF 25V A-LO-CLAMP

120R R6 3 | 7 | A-LO-GATE

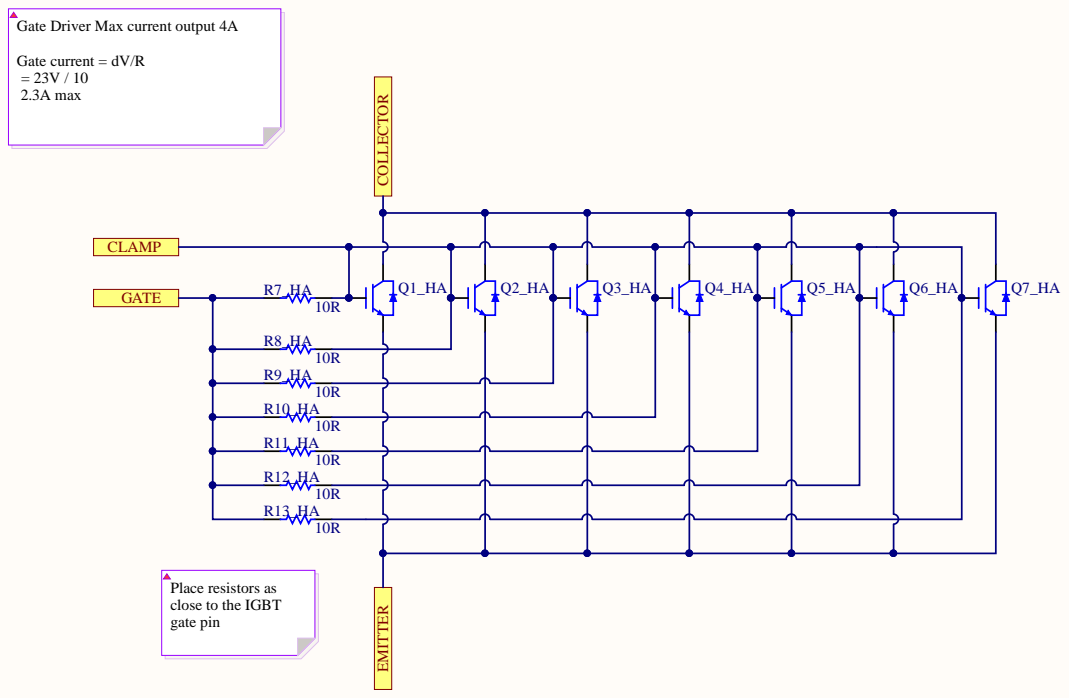
[picture p15: page 3]

Gate Driver Max current output 4A

Place resistors as
close to the IGBT
gate pin

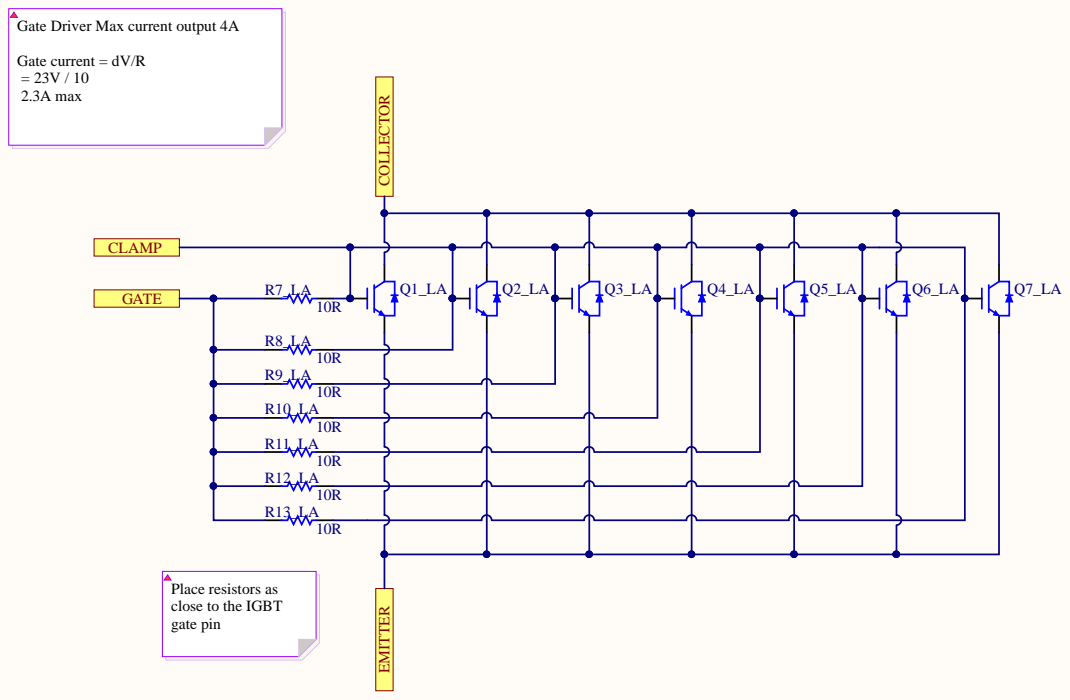
[picture p16: page 4]

Gate Driver Max current output 4A

Place resistors as
close to the IGBT
gate pin

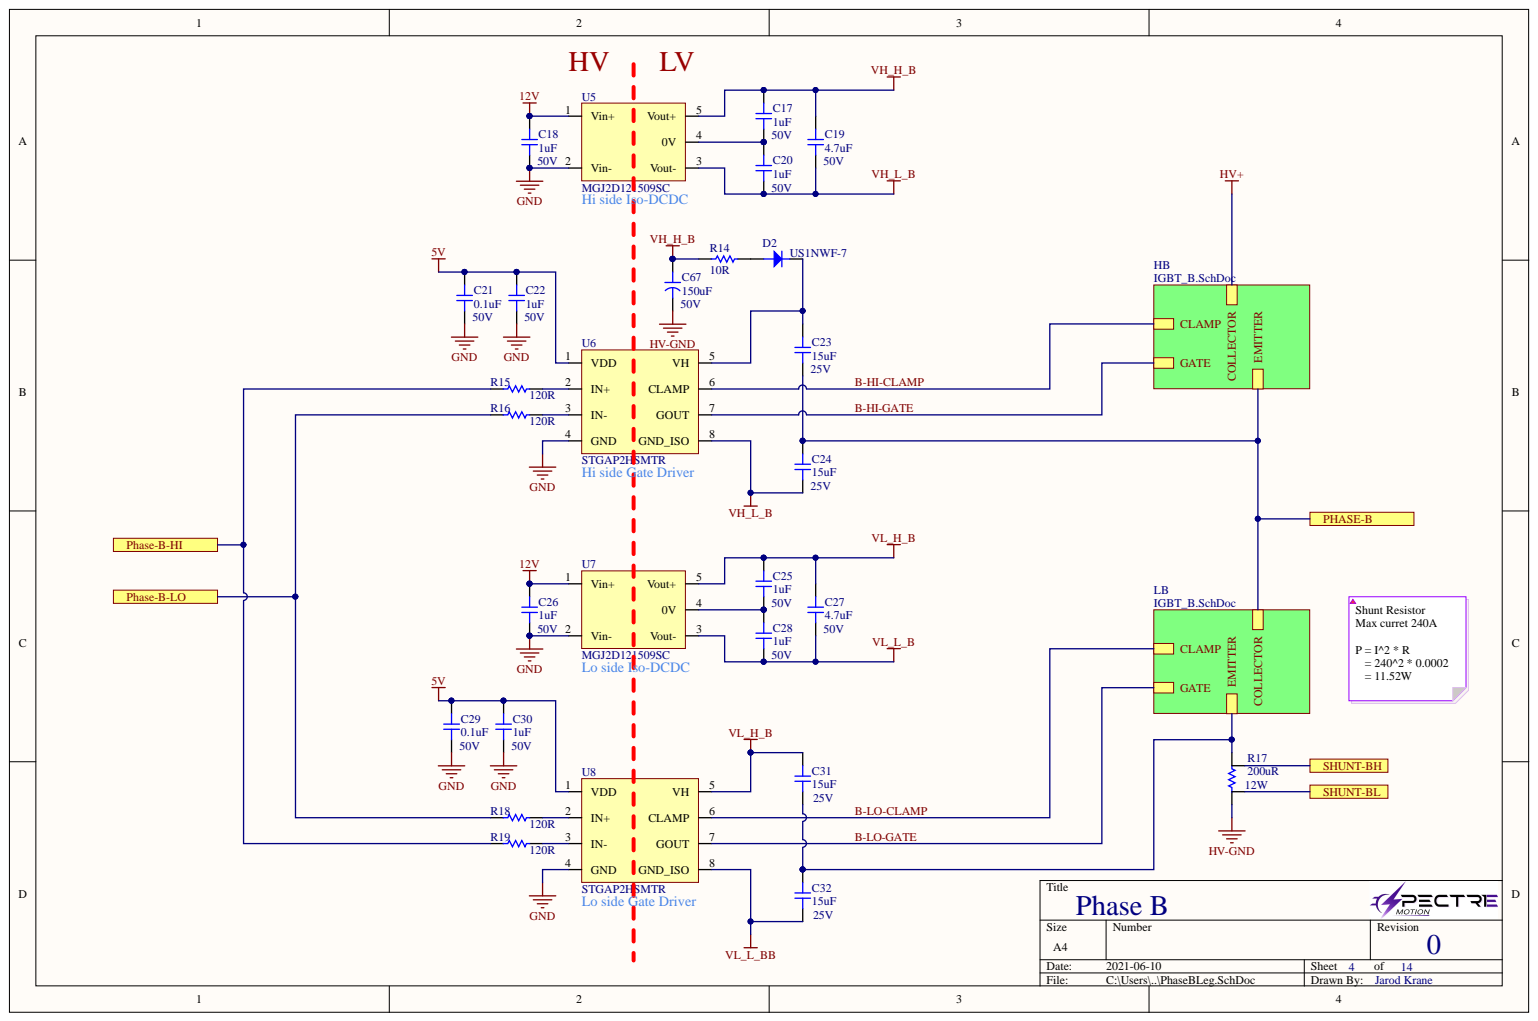
[picture p17: page 5]

B-HI-CLAMP

120R R16 3 | 7 | B-HI-GATE

C31 15uF 25V B-LO-CLAMP

120R R19 3 | 7 | B-LO-GATE

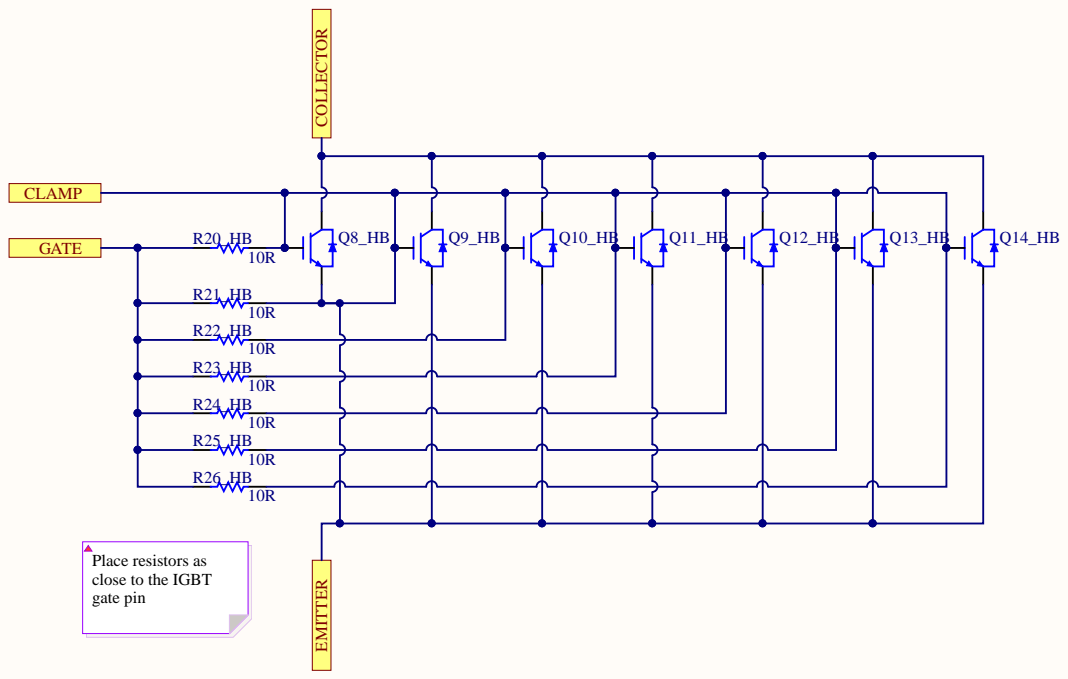
[picture p18: page 6]

Place resistors as
close to the IGBT
gate pin

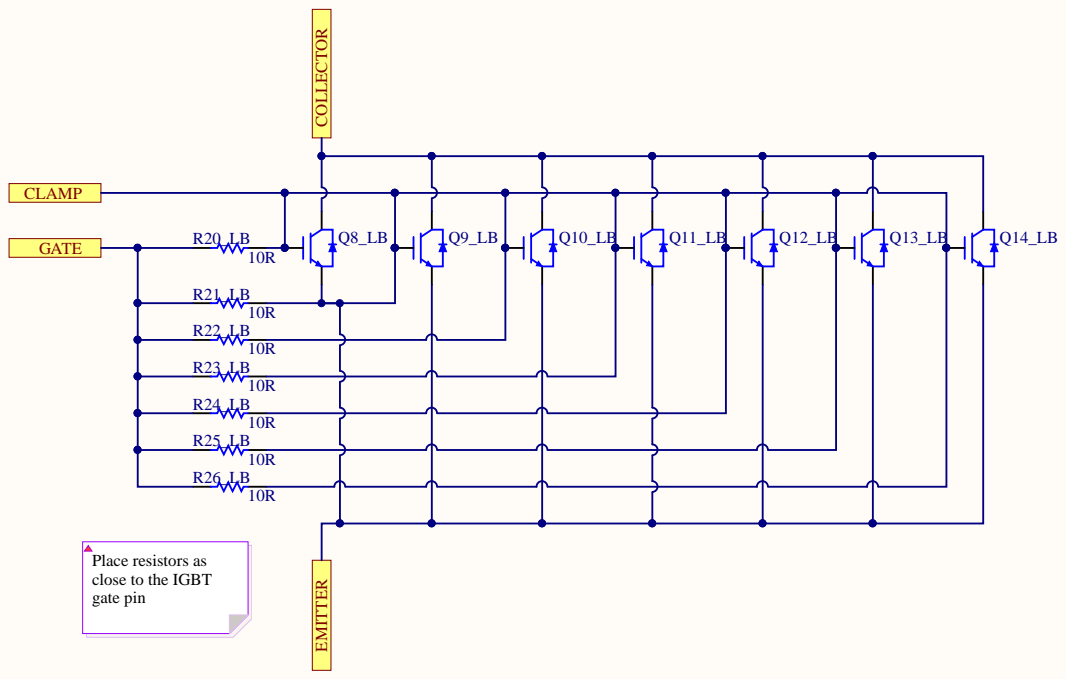
[picture p19: page 7]

Place resistors as
close to the IGBT
gate pin

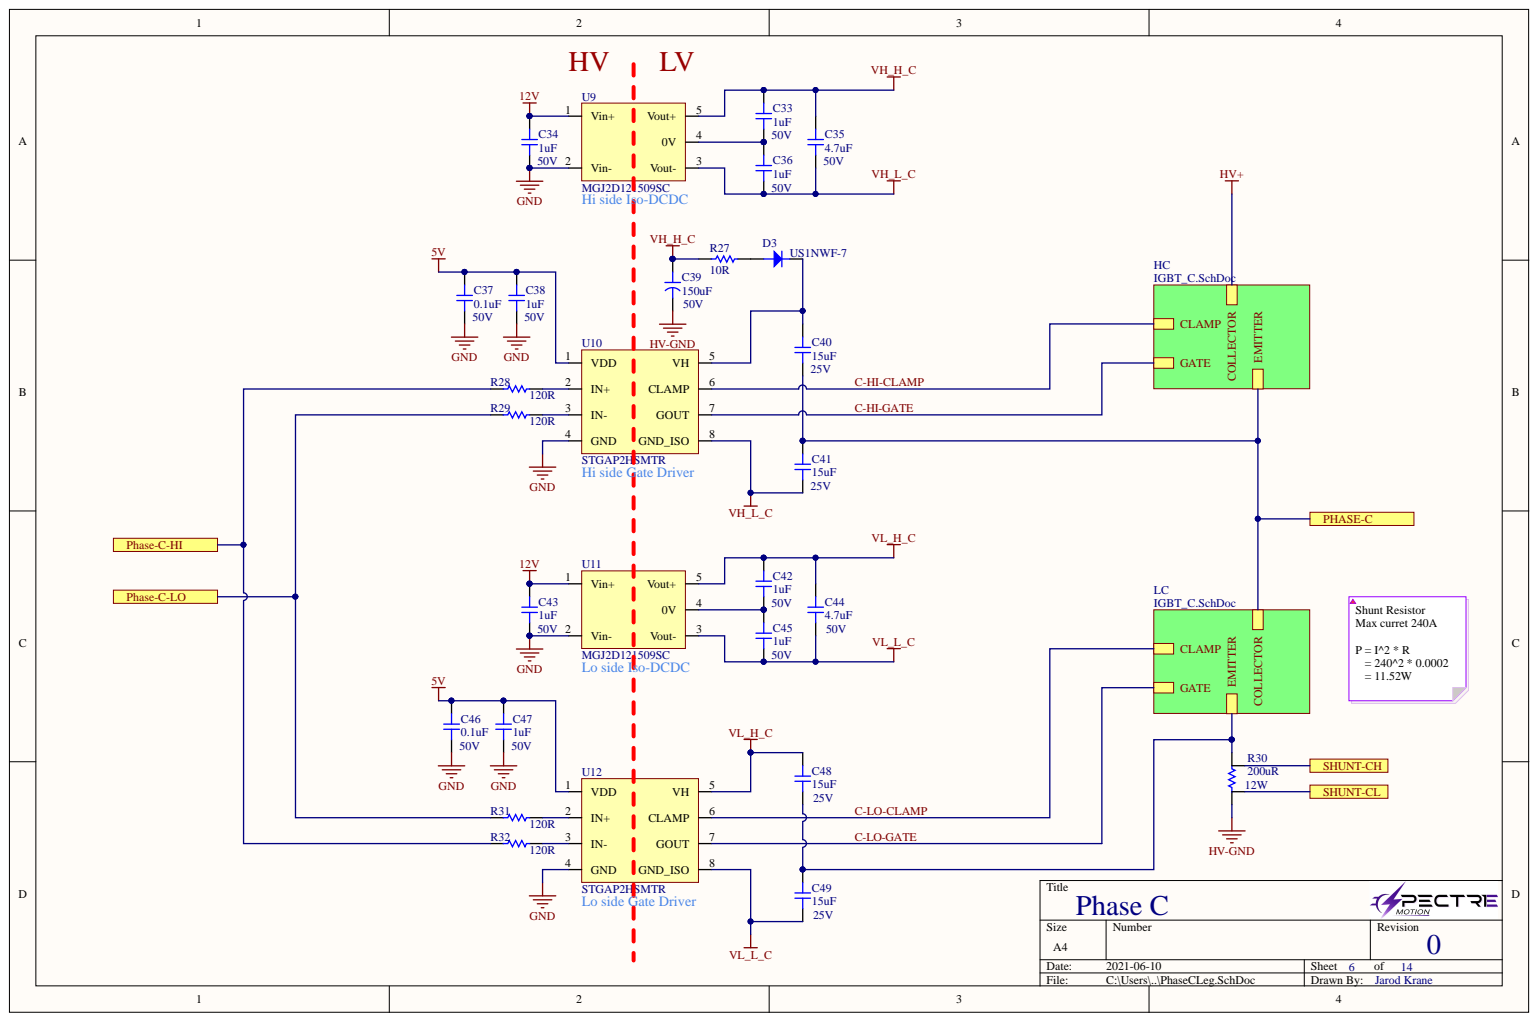
[picture p20: page 8]

C-HI-CLAMP

120R R29 3 | 7 | C-HI-GATE

C48 15uF 25V C-LO-CLAMP

120R R32 3 | 7 | C-LO-GATE

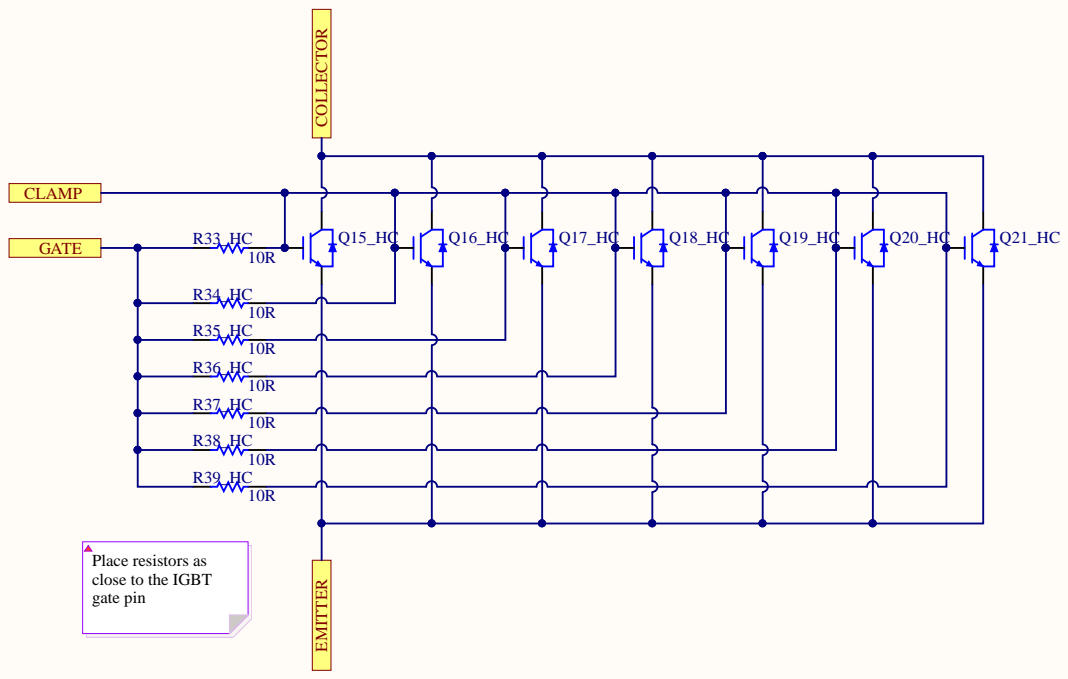
[picture p21: page 9]

Place resistors as
close to the IGBT
gate pin

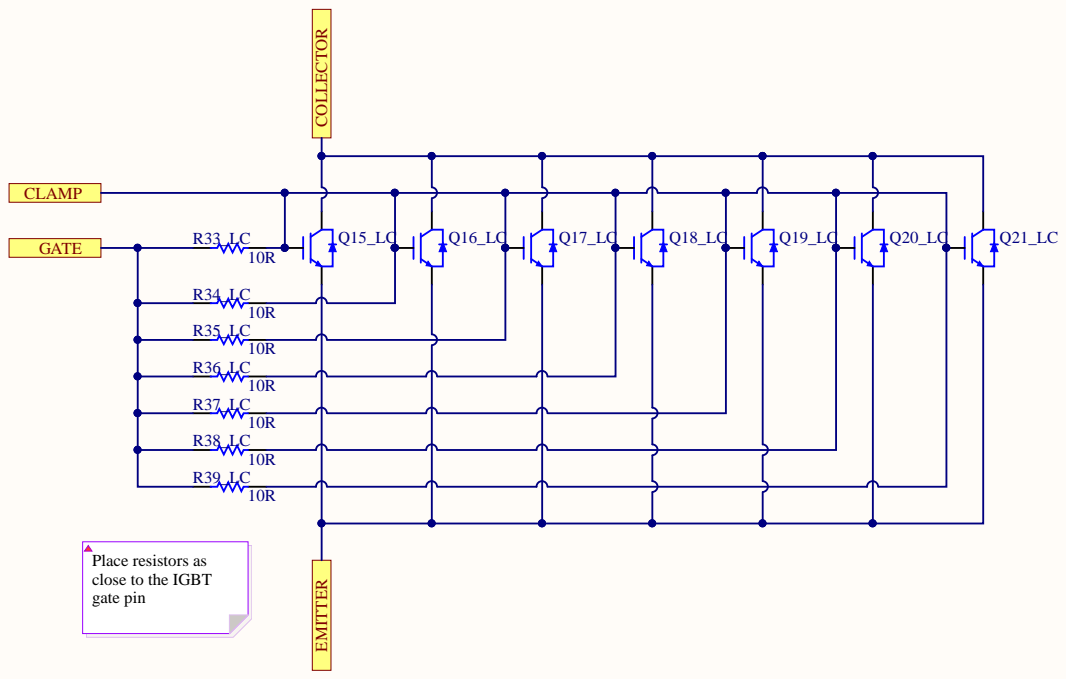
[picture p22: page 10]

Place resistors as
close to the IGBT
gate pin

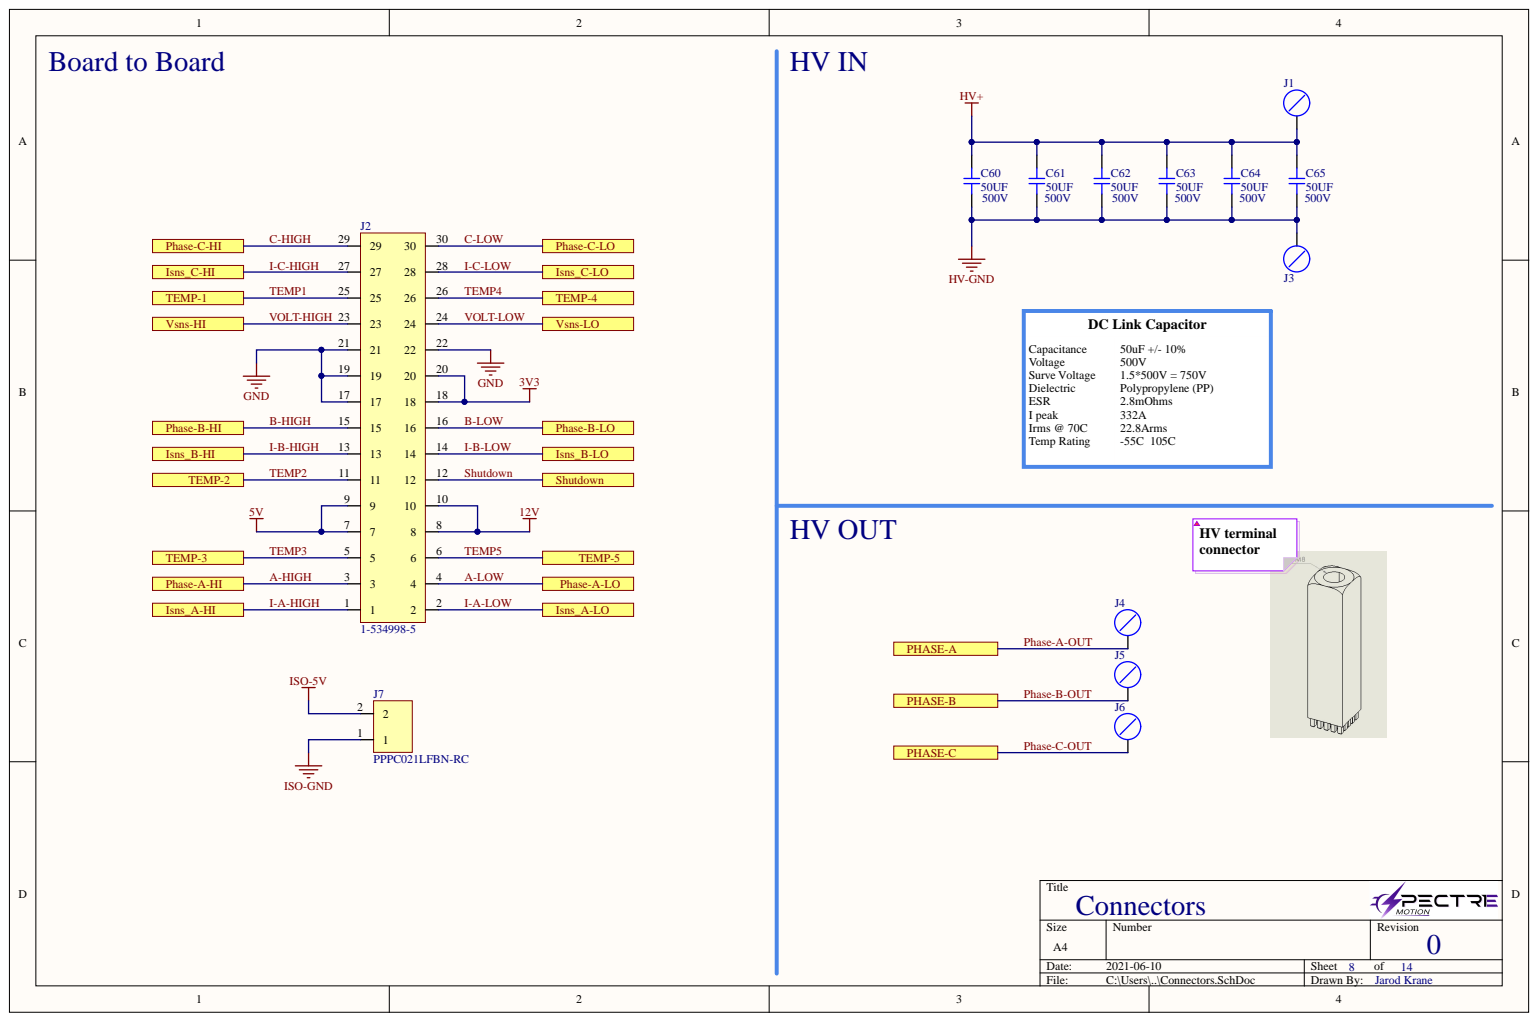
[picture p23: page 11]

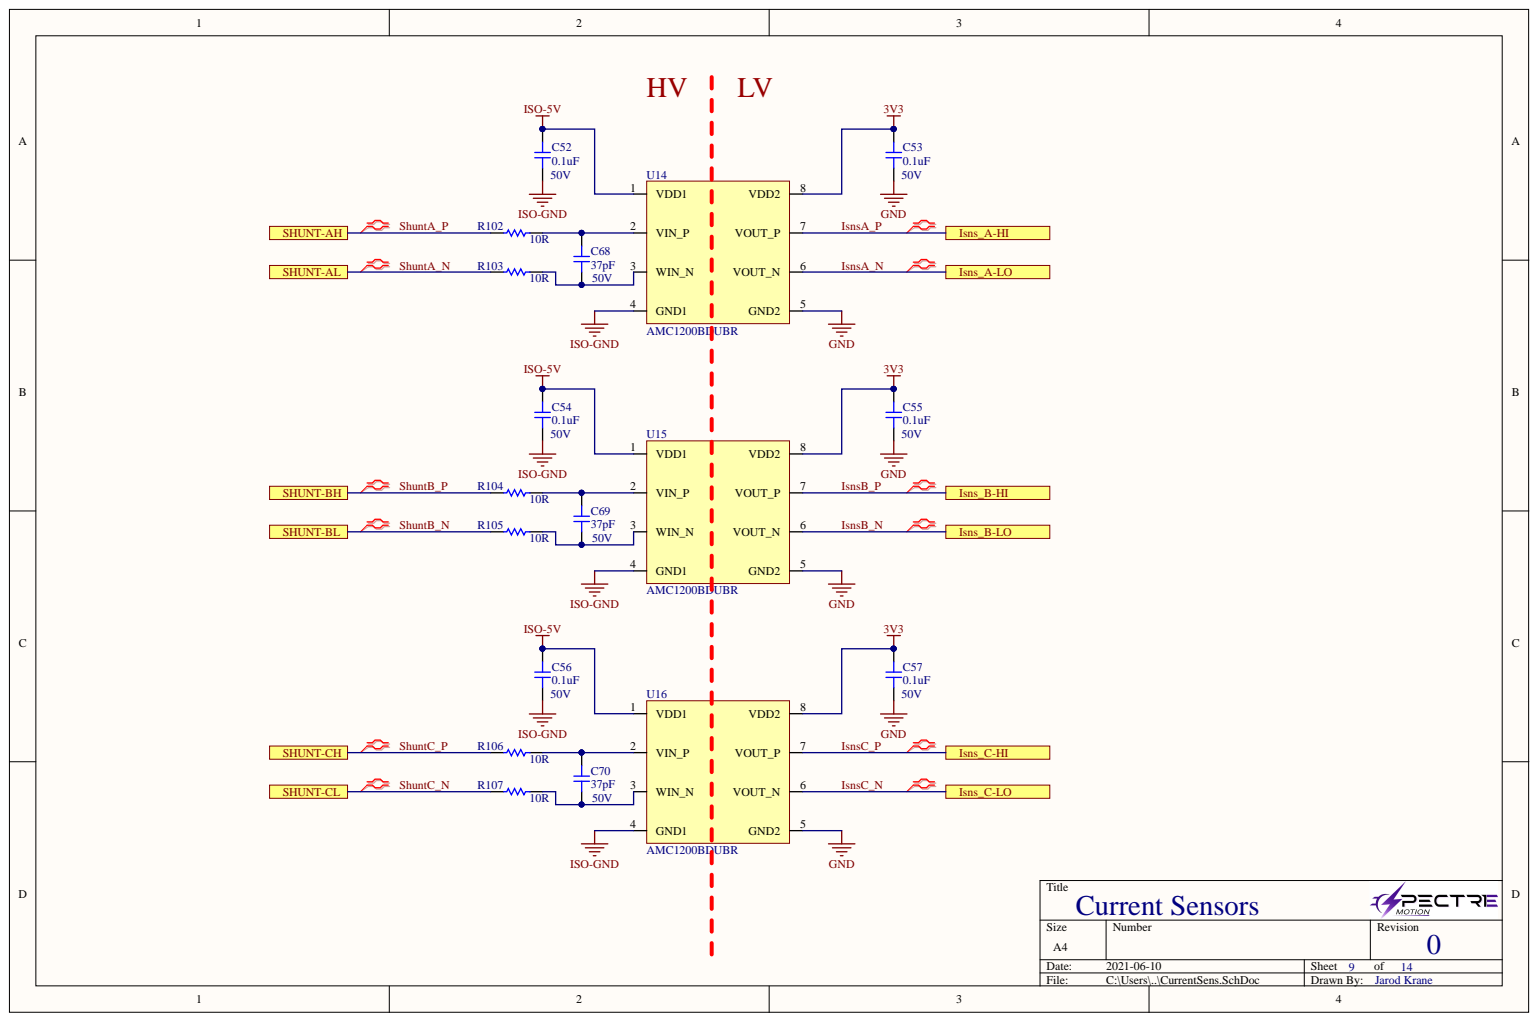
[picture p24: page 12]

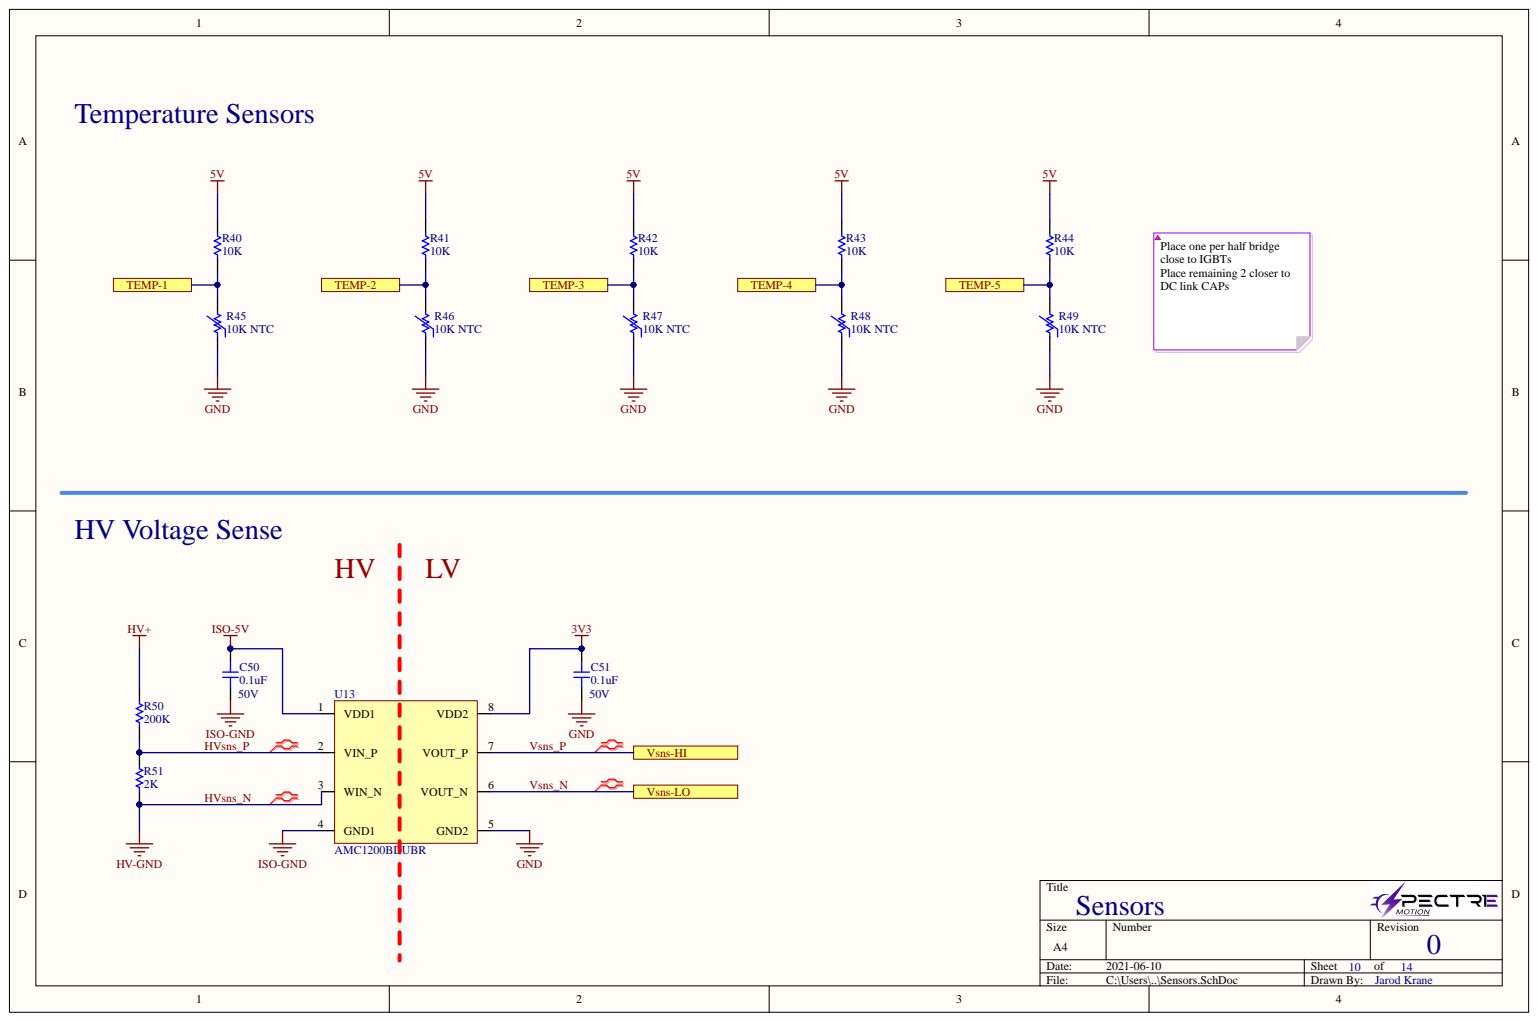
[picture p25: page 13]

Place one per half bridge
close to IGBTs
Place remaining 2 closer to
DC link CAPs

HVsns_N

WIN_N 3

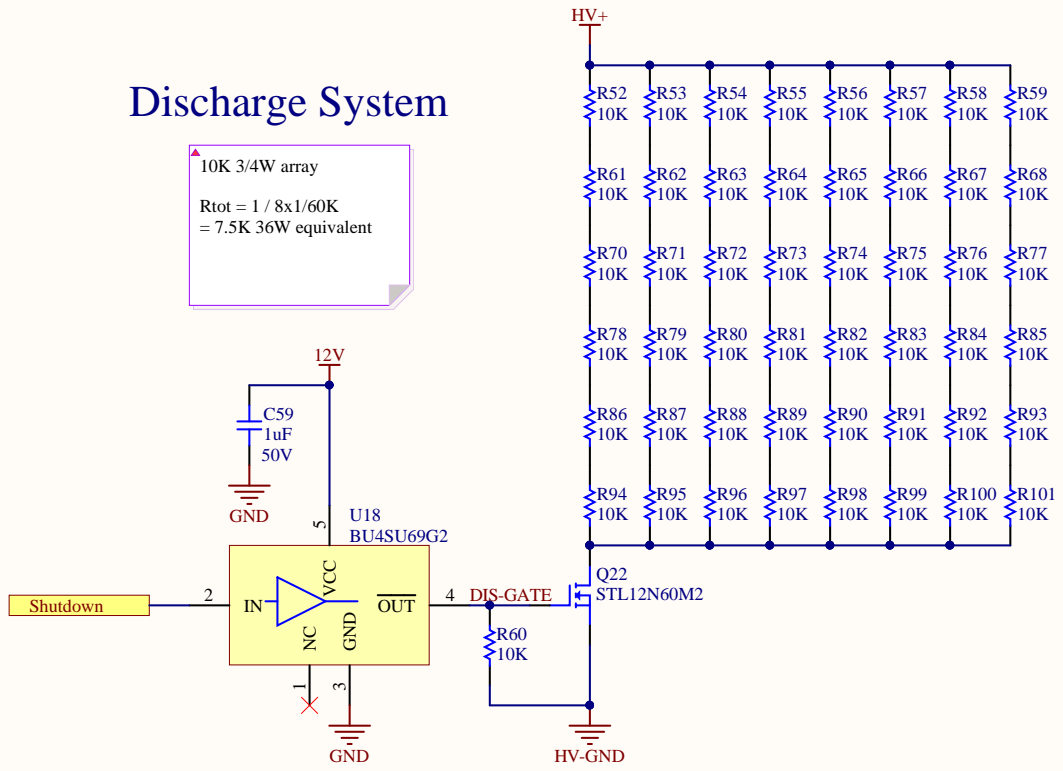
[picture p26: page 14]
