ADivinagracia1/spectre-inverter-capstone/(list of files, drawings)

Other design files:
AltiumLibrary/inverter-libraries.PrjPCB
AltiumLibrary/InverterSCHLib.SchLib
controls-pcb/ControlBoard.PrjPCB
controls-pcb/CTR_CAN.SchDoc
controls-pcb/CTR_Connectors.SchDoc
controls-pcb/CTR_MCU_Circuits.SchDoc
controls-pcb/CTR_MCU_Power.SchDoc
controls-pcb/CTR_MCU_Signals.SchDoc
controls-pcb/CTR_Power_Supply.SchDoc
controls-pcb/CTR_Precharge.SchDoc
controls-pcb/CTR_Top.SchDoc
controls-pcb/CTR_USB.SchDoc
controls-pcb/CTR_UVOV.SchDoc
power-pcb/AIRControl.SchDoc
power-pcb/Connectors.SchDoc
power-pcb/CurrentSens.SchDoc
power-pcb/IGBT.SchDoc
power-pcb/IGBT_A.SchDoc
power-pcb/IGBT_B.SchDoc
power-pcb/IGBT_C.SchDoc
power-pcb/InverterPCBLib.PcbLib
power-pcb/InverterSCHLib.SchLib
power-pcb/PhaseALeg.SchDoc
power-pcb/PhaseBLeg.SchDoc
power-pcb/PhaseCLeg.SchDoc
power-pcb/PowerBoard.PrjPCB
power-pcb/PowerBoard.SchDoc
power-pcb/Sensors.SchDoc
